FelipeAvilaSilva/Potentiostat_FullyDifferential/README.md

# Potentiostat_FullyDifferential
 Desenvolvimento de um Potenciostato Diferencial para detecção de metais pesados em corpos aquáticos
