FelipeAvilaSilva/Potentiostat_FullyDifferential/Gráficos/placa_ensaio/stock/readme.txt

1 - eletrodo ruim - 1 teste
2 - eletrodo bom 100mv -1v a 1v
3 - eletrodo bom 25mv -1v a 1v
4 - eletrodo bom 25mv 0.2v a 0.8v
