FelipeAvilaSilva/Potentiostat_FullyDifferential/Gráficos/placa_ensaio/fully/resistor155k_fully.png

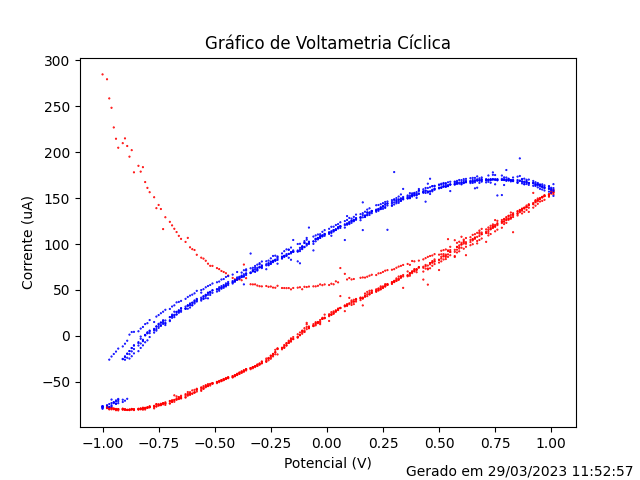
Gráficos/placa_ensaio/fully/resistor155k_fully.png
