FelipeAvilaSilva/Potentiostat_FullyDifferential/Gráficos/placa_ensaio/stock/2_resistor_stock.png

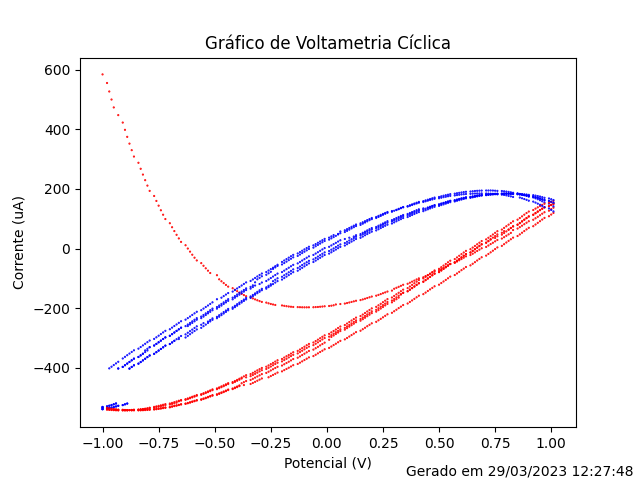
Gráficos/placa_ensaio/stock/2_resistor_stock.png
