FelipeAvilaSilva/Potentiostat_FullyDifferential/Gráficos/placa_ensaio/stock/KOH6M_stock.png

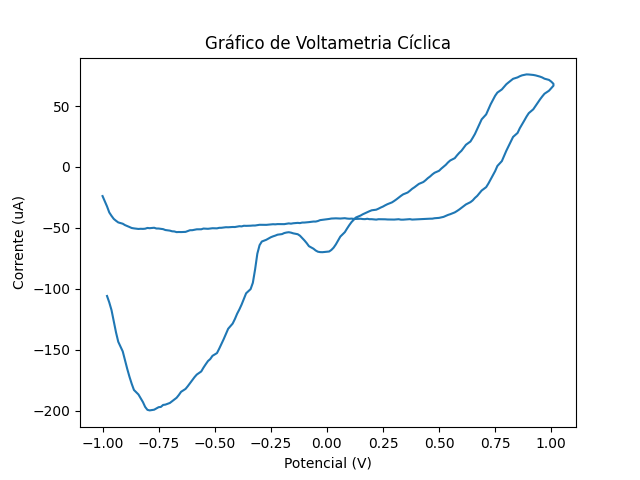
Gráficos/placa_ensaio/stock/KOH6M_stock.png
