FelipeAvilaSilva/Potentiostat_FullyDifferential/Gráficos/placa_ensaio/stock/resistor_stock.png

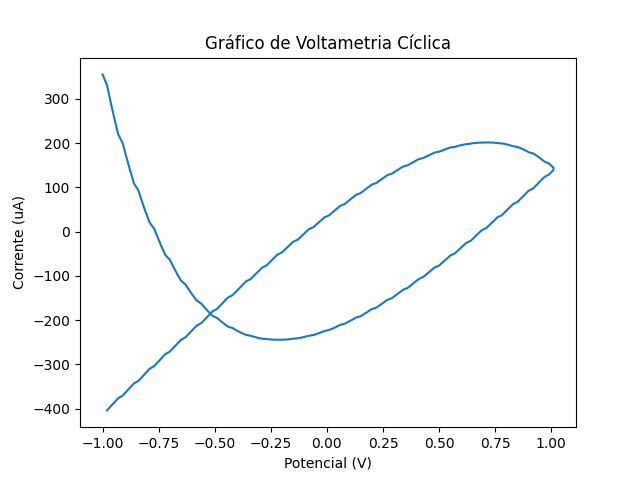
Gráficos/placa_ensaio/stock/resistor_stock.png
