FelipeAvilaSilva/Potentiostat_FullyDifferential/Gráficos/simulação/fully/fully.png

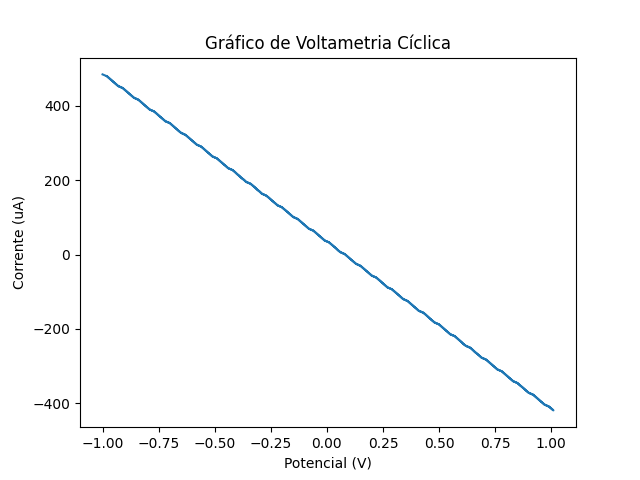
Gráficos/simulação/fully/fully.png
