FelipeAvilaSilva/Potentiostat_FullyDifferential/Gráficos/simulação/fully/fully_sinalinvertido.png

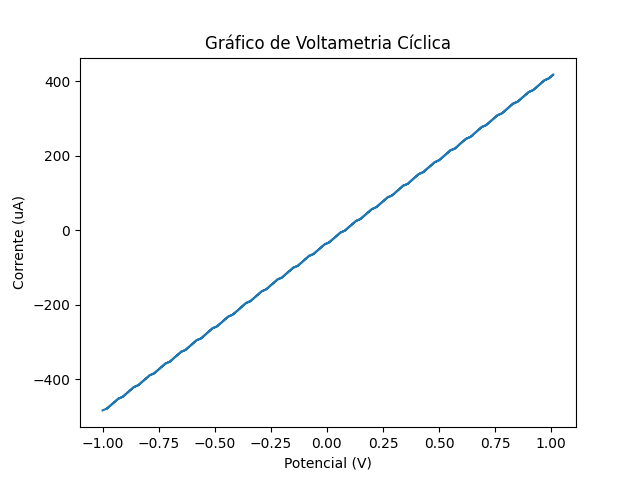
Gráficos/simulação/fully/fully_sinalinvertido.png
