FelipeAvilaSilva/Potentiostat_FullyDifferential/Validação/fully.png

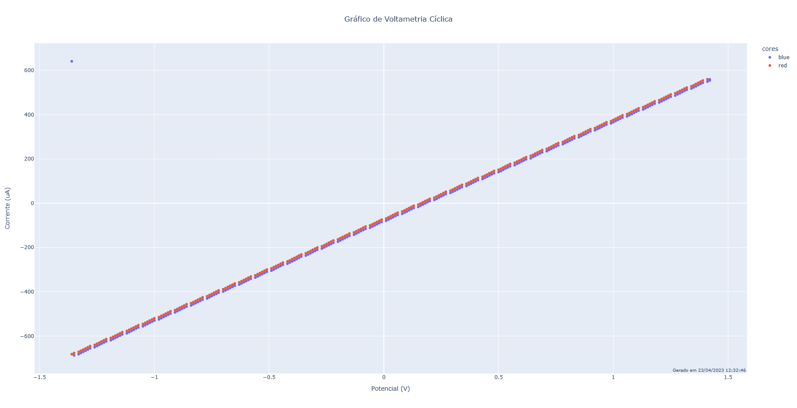
Validação/fully.png
