FelipeAvilaSilva/Potentiostat_FullyDifferential/Validação/PC_Lab/06.12.23-fully/s1_branco_volt_25_1.png

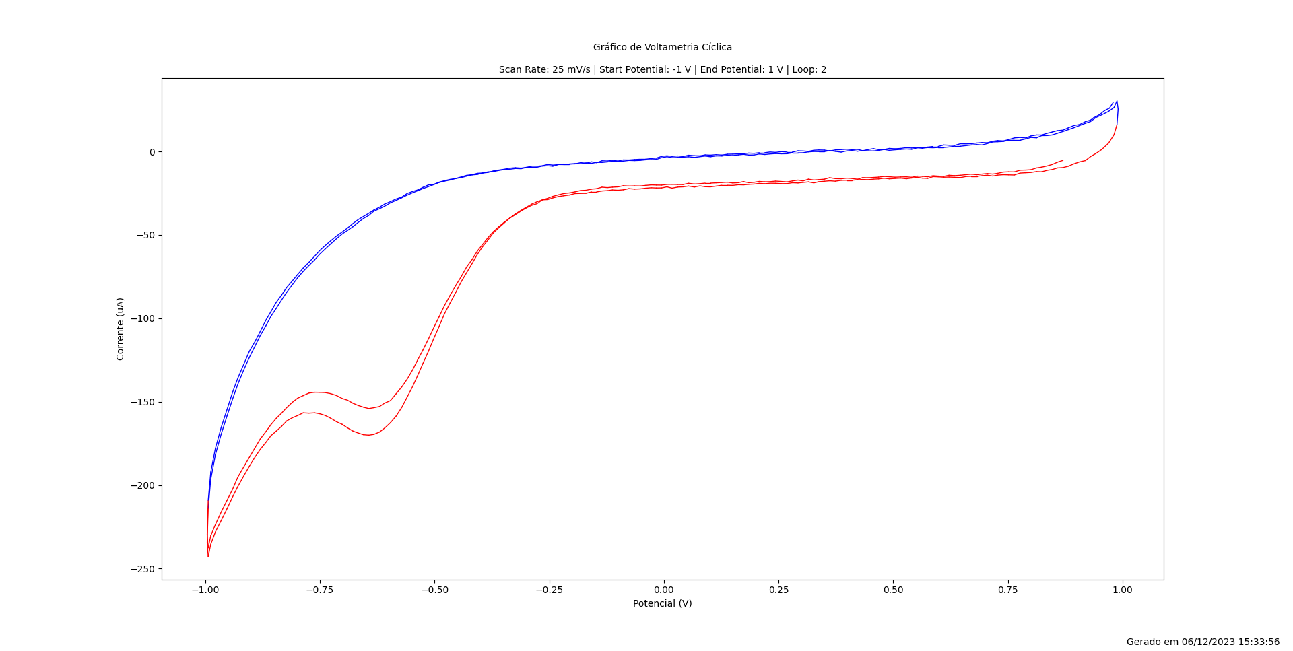
Validação/PC_Lab/06.12.23-fully/s1_branco_volt_25_1.png
