FelipeAvilaSilva/Potentiostat_FullyDifferential/Validação/PC_Lab/06.12.23-fully/s1_branco_volt_50_1.png

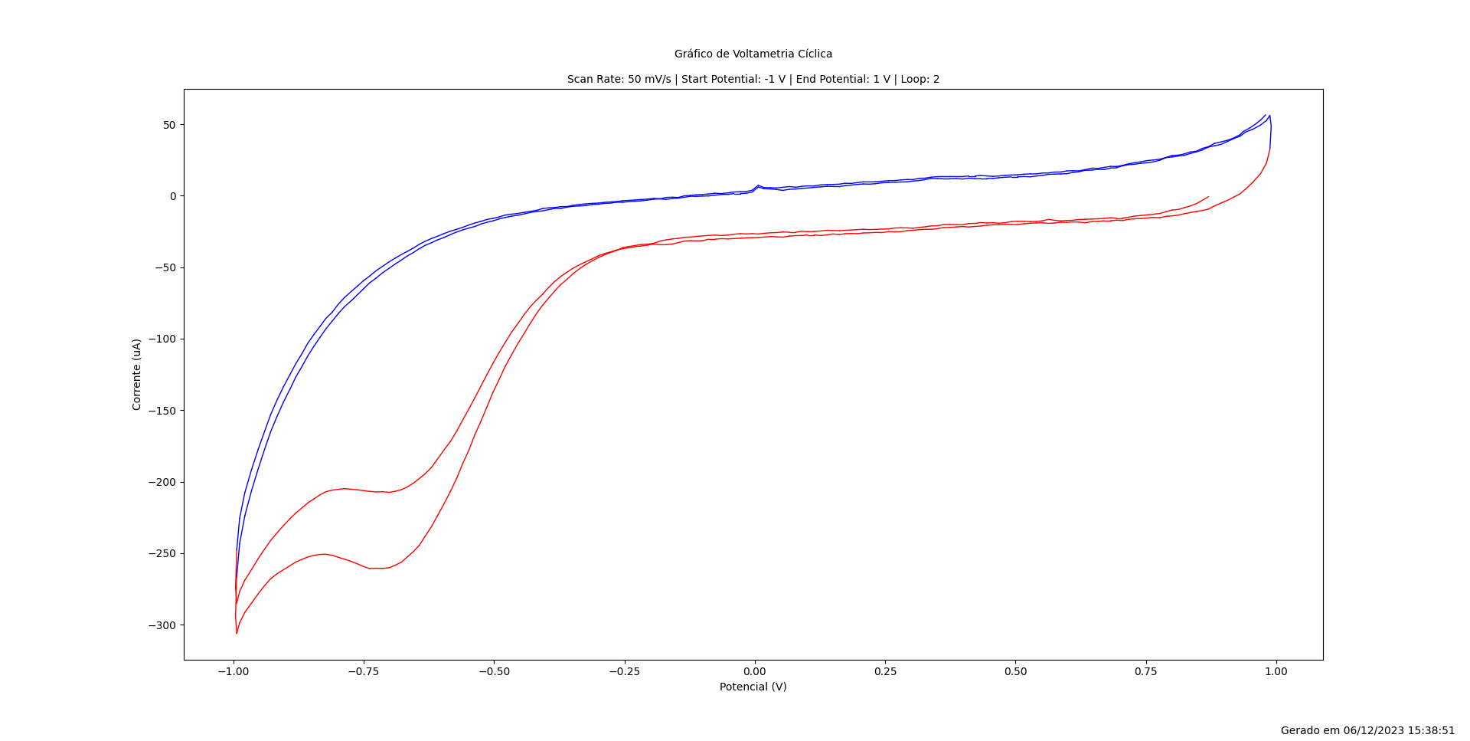
Validação/PC_Lab/06.12.23-fully/s1_branco_volt_50_1.png
