FelipeAvilaSilva/Potentiostat_FullyDifferential/Validação/PC_Lab/06.12.23-fully/s1_cont_volt_50_2.png

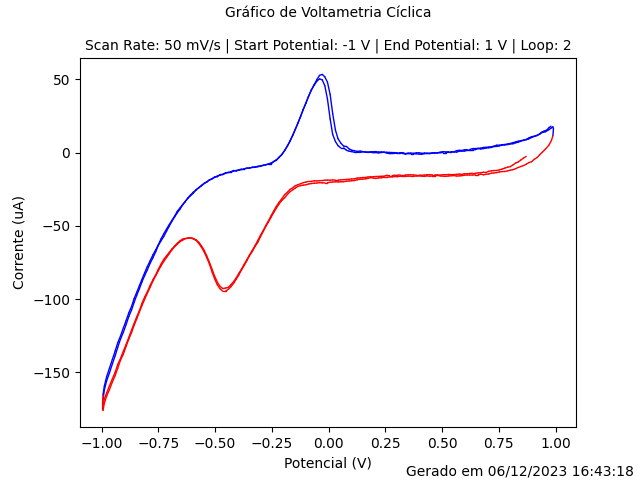
Validação/PC_Lab/06.12.23-fully/s1_cont_volt_50_2.png
