FelipeAvilaSilva/Potentiostat_FullyDifferential/Validação/PC_Lab/06.12.23-fully/s1_cont_volt_150_1.png

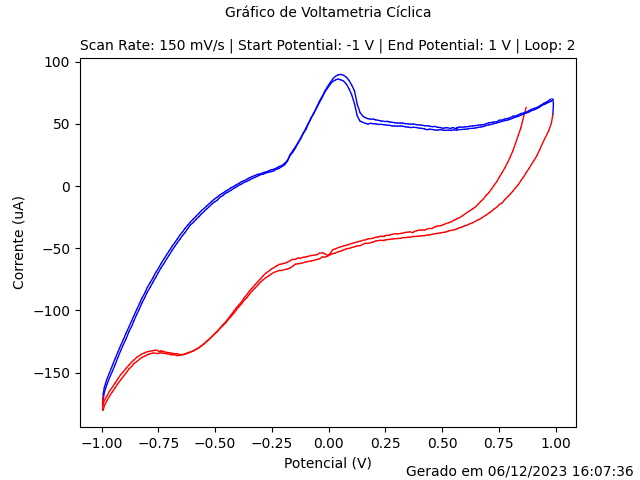
Validação/PC_Lab/06.12.23-fully/s1_cont_volt_150_1.png
