FelipeAvilaSilva/Potentiostat_FullyDifferential/Validação/VfinalFullyPotentiostat2.png

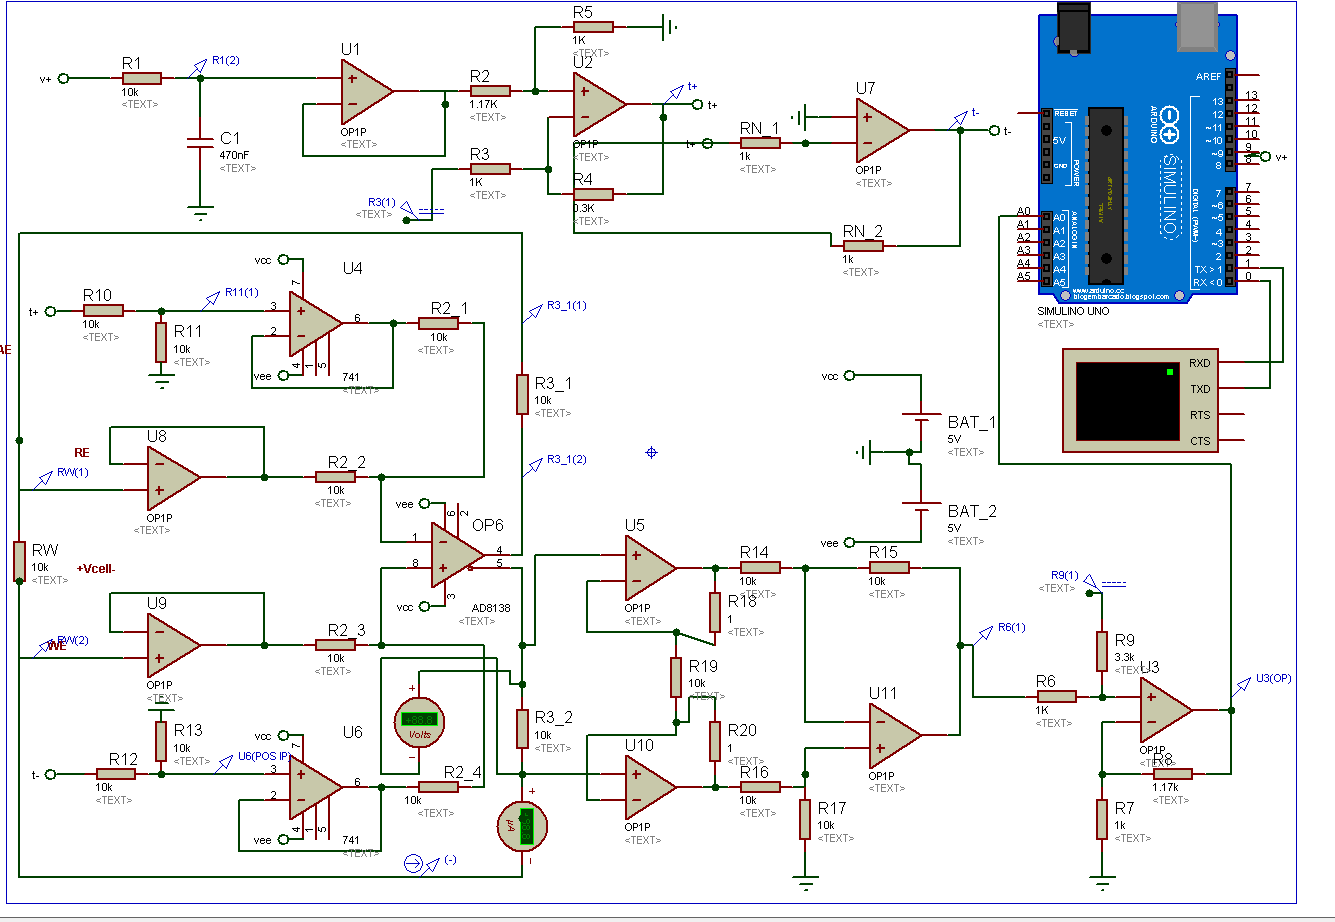
Validação/VfinalFullyPotentiostat2.png
