FelipeAvilaSilva/Potentiostat_FullyDifferential/Validação/vFinalStockPotentiostat2.png

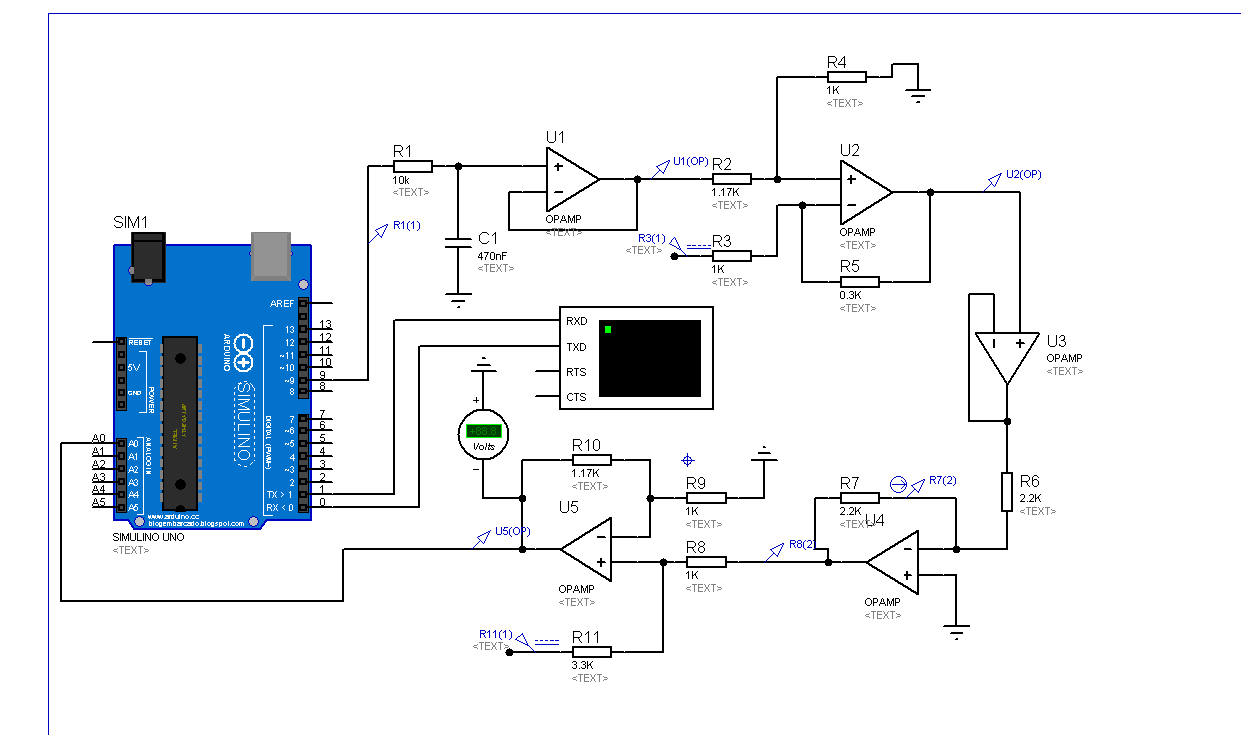
Validação/vFinalStockPotentiostat2.png
