FelipeAvilaSilva/Potentiostat_FullyDifferential/Print/Resistor_Fully_12bits_vTCC.png

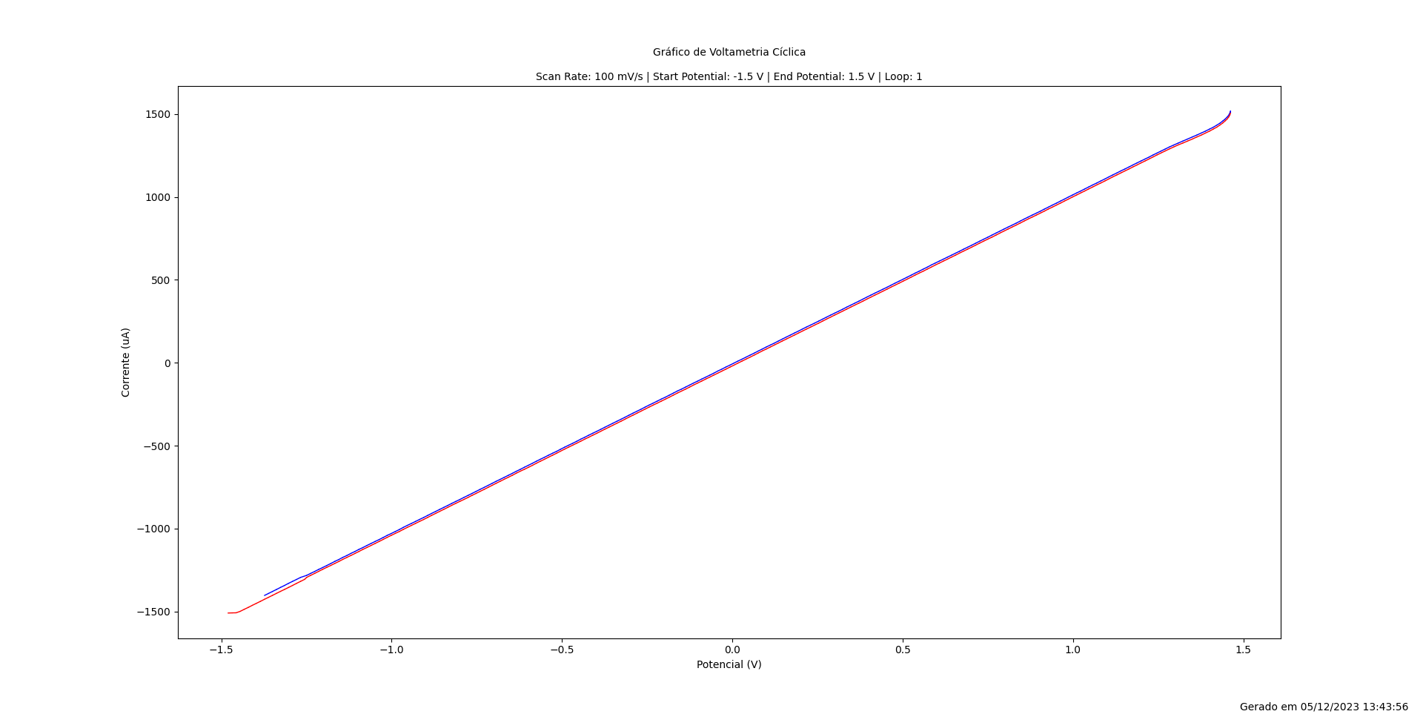
Print/Resistor_Fully_12bits_vTCC.png
