FelipeAvilaSilva/Potentiostat_FullyDifferential/Validação/SE_SIMU.pdf

# 800 Corrente ⁽uA⁾

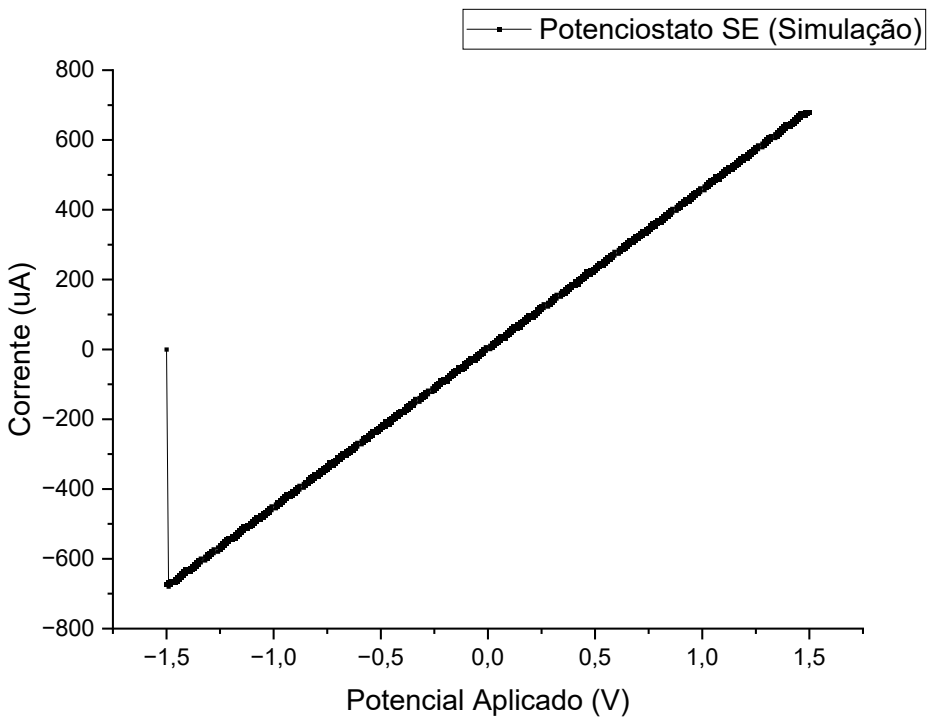
[picture p20: page 1]
Potencial Aplicado (V)

Potenciostato SE (Simulação)
