FelipeAvilaSilva/Potentiostat_FullyDifferential/(list of files, drawings)

Other design files:
Codigo/Proteus/poten_fully.DSN
Codigo/Proteus/poten_fully_v2.DSN
Codigo/Proteus/poten_fully_vfinal.DSN
Codigo/Proteus/poten_fully_vTCC.DSN
Codigo/Proteus/poten_single.DSN
Codigo/Proteus/poten_stock.DSN
Outros_Testes/potenciostato_fully.DSN
Outros_Testes/potenciostato_fully_v2.DSN
Outros_Testes/potenciostato_single_v1.DSN
PCB/fully_differential/fully_differential/freerouting.dsn
