FelipeAvilaSilva/Potentiostat_FullyDifferential/PCB/fully_differential/fully_differential/TCC_FULLY_SMD/TCC_FULLY_SMD.kicad_pcb

## KiCad design PCB/fully_differential/fully_differential/TCC_FULLY_SMD/TCC_FULLY_SMD.kicad_pcb (2024-01-31)

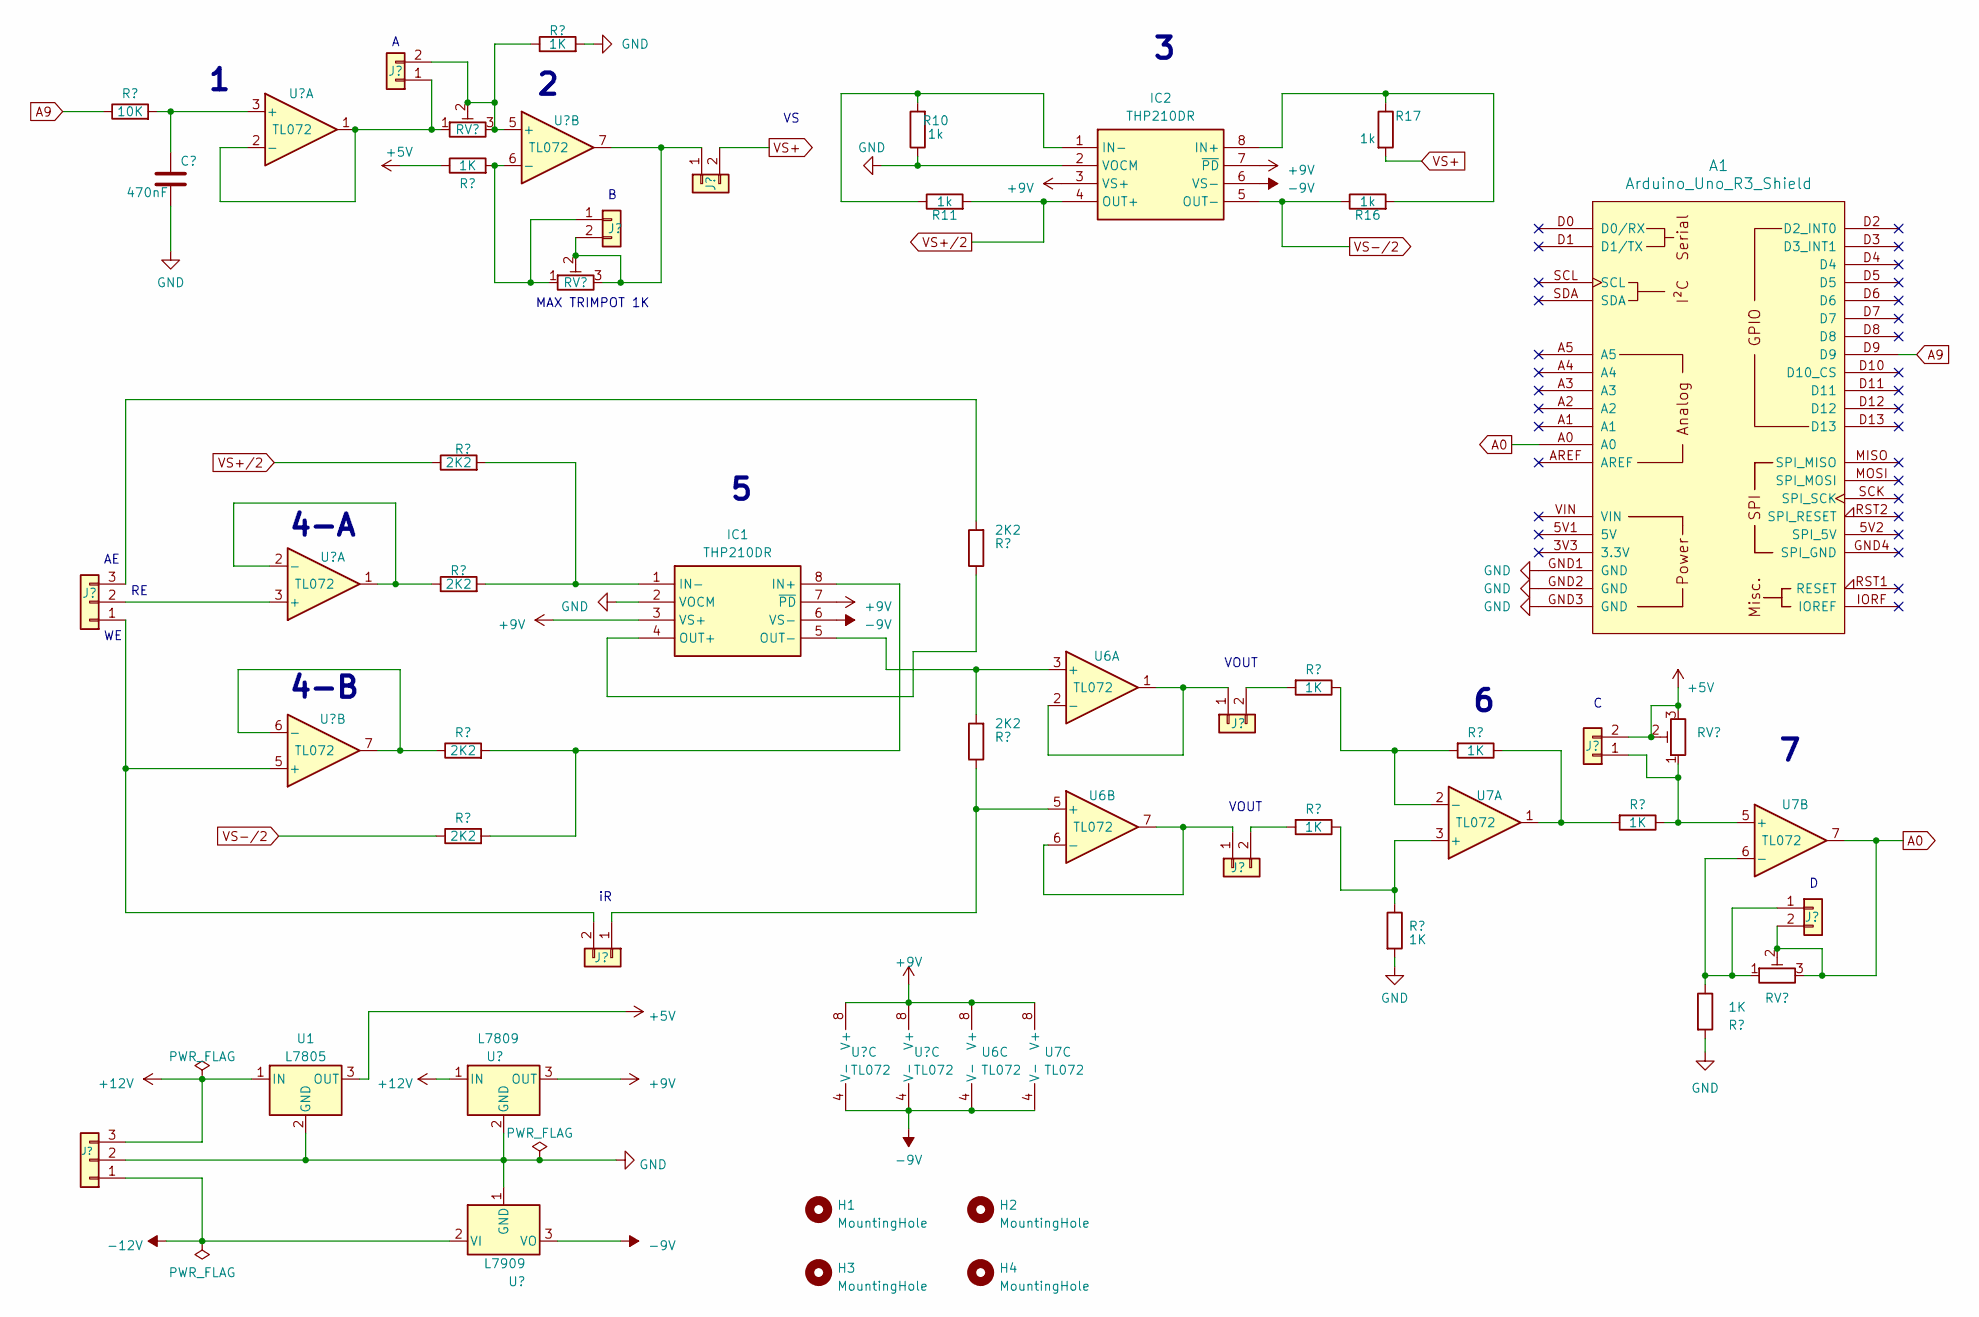
[picture p21: schematic TCC_FULLY_SMD.kicad_sch, Potenciosato Fully Differential]

Parts:
A1: Arduino_Uno_R3_Shield
C2: 470nF; C_Rect_L19.0mm_W6.0mm_P15.00mm_MKS4
H1, H2, H3, H4: MountingHole; MountingHole_3mm_Pad
IC1, IC2: THP210DR; SOIC127P600X175-8N; Mouser Part Number 595-THP210DR
J1: Conn_01x03; PinSocket_1x03_P2.54mm_Vertical
J2: Conn_01x03; Stocko_MKS_1653-6-0-303_1x3_P2.50mm_Vertical
J3, J4, J5, J6, J7, J8, J10, J11: Conn_01x02; PinHeader_1x02_P2.54mm_Vertical
R1: 10K; R_0805_2012Metric_Pad1.20x1.40mm_HandSolder
R2, R3, R4, R5, R8, R9: 2K2; R_0805_2012Metric_Pad1.20x1.40mm_HandSolder
R6, R7, R12, R13, R14, R15, R18, R19: 1K; R_0805_2012Metric_Pad1.20x1.40mm_HandSolder
R10, R11, R16, R17: 1k; R_0805_2012Metric_Pad1.20x1.40mm_HandSolder
RV1, RV2, RV3, RV4: R_Potentiometer_Trim; Potentiometer_Bourns_3296W_Vertical
U1: L7805; TO255P460X1020X2008-3P
U2, U3, U6, U7: TL072; DIP-8_W7.62mm_Socket_LongPads
U4: L7809; TO255P460X1020X2008-3P
U5: L7909; TO255P460X1020X2008-3P

Connections:
+5V: J10.2, R6.1, RV3.2, RV3.3, U1.3 (OUT)
+9V: IC1.3 (VS+), IC1.7 (~PD), IC2.3 (VS+), IC2.7 (~PD), U2.8 (V+), U3.8 (V+), U4.3 (OUT), U6.8 (V+), U7.8 (V+)
+12V: J2.3, U1.1 (IN), U4.1 (IN)
-9V: IC1.6 (VS-), IC2.6 (VS-), U2.4 (V-), U3.4 (V-), U5.3 (VO), U6.4 (V-), U7.4 (V-)
-12V: J2.1, U5.2 (VI)
A0: A1.A0, J11.2, RV4.2, RV4.3, U7.7
A9: A1.D9, R1.1
GND: A1.GND1 (GND), A1.GND2 (GND), A1.GND3 (GND), C2.2, IC1.2 (VOCM), IC2.2 (VOCM), J2.2, R7.2, R10.1, R14.2, R19.2, U1.2 (GND), U4.2 (GND), U5.1 (GND)
unnamed: IC1.8 (IN+), R4.2, R5.2
unnamed: IC1.1 (IN-), R2.2, R3.2
unnamed: IC1.4 (OUT+), R8.1
unnamed: IC1.5 (OUT-), R9.2, U6.3 (+)
unnamed: IC2.8 (IN+), R16.2, R17.1
unnamed: IC2.1 (IN-), R10.2, R11.1
unnamed: J1.1, J4.2, U2.5 (+)
unnamed: J1.2, U2.3 (+)
unnamed: J1.3, R8.2
unnamed: J3.1, RV1.1, U3.1, U3.2 (-)
unnamed: J3.2, R7.1, RV1.2, RV1.3, U3.5 (+)
unnamed: J4.1, R9.1, U6.5 (+)
unnamed: J5.1, R6.2, RV2.1, U3.6 (-)
unnamed: J5.2, J6.1, RV2.2, RV2.3, U3.7
unnamed: J7.1, U6.1, U6.2 (-)
unnamed: J7.2, R12.2
unnamed: J8.1, U6.6 (-), U6.7
unnamed: J8.2, R13.2
unnamed: J10.1, R18.1, RV3.1, U7.5 (+)
unnamed: J11.1, R19.1, RV4.1, U7.6 (-)
unnamed: R15.1, R18.2, U7.1
unnamed: R3.1, U2.1, U2.2 (-)
unnamed: R4.1, U2.6 (-), U2.7
unnamed: C2.1, R1.2, U3.3 (+)
unnamed: R13.1, R14.1, U7.3 (+)
unnamed: R12.1, R15.2, U7.2 (-)
VS+: J6.2, R17.2
VS+/2: IC2.4 (OUT+), R2.1, R11.2
VS-/2: IC2.5 (OUT-), R5.1, R16.1

Notes on the sheet:
VOUT
4-B
4-A
MAX TRIMPOT 1K

Board: 2 copper layers, 48 parts (0 on the bottom side), 37 nets, no tracks yet.
