FelipeAvilaSilva/Potentiostat_FullyDifferential/PCB/stock/stock_v2/stock_v2.kicad_pcb

## KiCad design PCB/stock/stock_v2/stock_v2.kicad_pcb (2023-06-19)

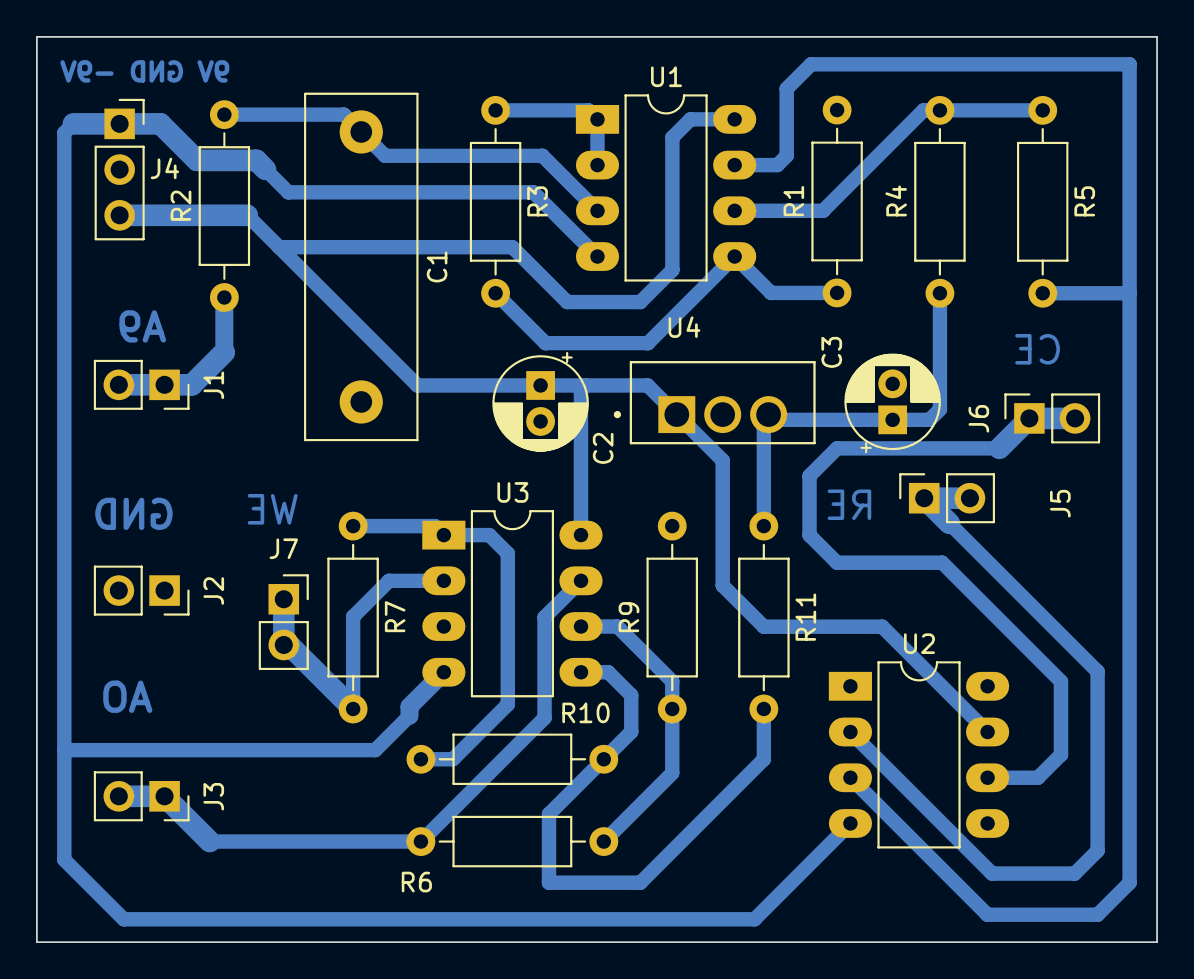
[picture p22: board stock_v2.kicad_pcb from above]

Board: 2 copper layers, 62.2 x 50.3 mm, 24 parts (0 on the bottom side), 17 nets.

Parts:
C1: 470nF; C_Rect_L19.0mm_W6.0mm_P15.00mm_MKS4
C2, C3: 0.3uF; CP_Radial_D5.0mm_P2.00mm
J1, J2, J3, J5, J6, J7: Conn_01x02; PinSocket_1x02_P2.54mm_Vertical
J4: Conn_01x03; PinSocket_1x03_P2.54mm_Vertical
R1, R4, R9, R10: 1K; R_Axial_DIN0207_L6.3mm_D2.5mm_P10.16mm_Horizontal
R2: 10k; R_Axial_DIN0207_L6.3mm_D2.5mm_P10.16mm_Horizontal
R3, R6: 1.17K; R_Axial_DIN0207_L6.3mm_D2.5mm_P10.16mm_Horizontal
R5: 0.3K; R_Axial_DIN0207_L6.3mm_D2.5mm_P10.16mm_Horizontal
R7: 2.2K; R_Axial_DIN0207_L6.3mm_D2.5mm_P10.16mm_Horizontal
R11: 3.3K; R_Axial_DIN0207_L6.3mm_D2.5mm_P10.16mm_Horizontal
U1, U3: LM358; DIP-8_W7.62mm_LongPads
U2: LM741; DIP-8_W7.62mm_LongPads
U4: L7805; TO255P1020X450X2000-3

Connections:
+5V: C3.1, R4.1, R11.1, U4.3 (OUT)
+9V: C2.1, J4.3, U1.8 (V+), U2.7 (V+), U3.8 (V+), U4.1 (IN)
-9V: J4.1, U1.4 (V-), U2.4 (V-), U3.4 (V-)
GND: C1.2, C2.2, C3.2, J2.1, J2.2, J4.2, R1.2, R9.2, U3.3 (+), U4.2 (GND)
unnamed: J1.1, J1.2, R2.1
unnamed: J3.1, J3.2, R6.1, U3.7
unnamed: J5.1, J5.2, U2.2 (-)
unnamed: J6.1, J6.2, U2.6
unnamed: J7.1, J7.2, R7.2, U3.2 (-)
unnamed: R7.1, R10.2, U3.1
unnamed: C1.1, R2.2, U1.3 (+)
unnamed: R3.1, U1.1, U1.2 (-)
unnamed: R1.1, R3.2, U1.5 (+)
unnamed: R4.2, R5.1, U1.6 (-)
unnamed: R5.2, U1.7, U2.3 (+)
unnamed: R10.1, R11.2, U3.5 (+)
unnamed: R6.2, R9.1, U3.6 (-)
