FelipeAvilaSilva/Potentiostat_FullyDifferential/PCB/fully_differential/fully_differential/fully_differential_v8.kicad_pcb

## KiCad design PCB/fully_differential/fully_differential/fully_differential_v8.kicad_pcb (2023-08-18)

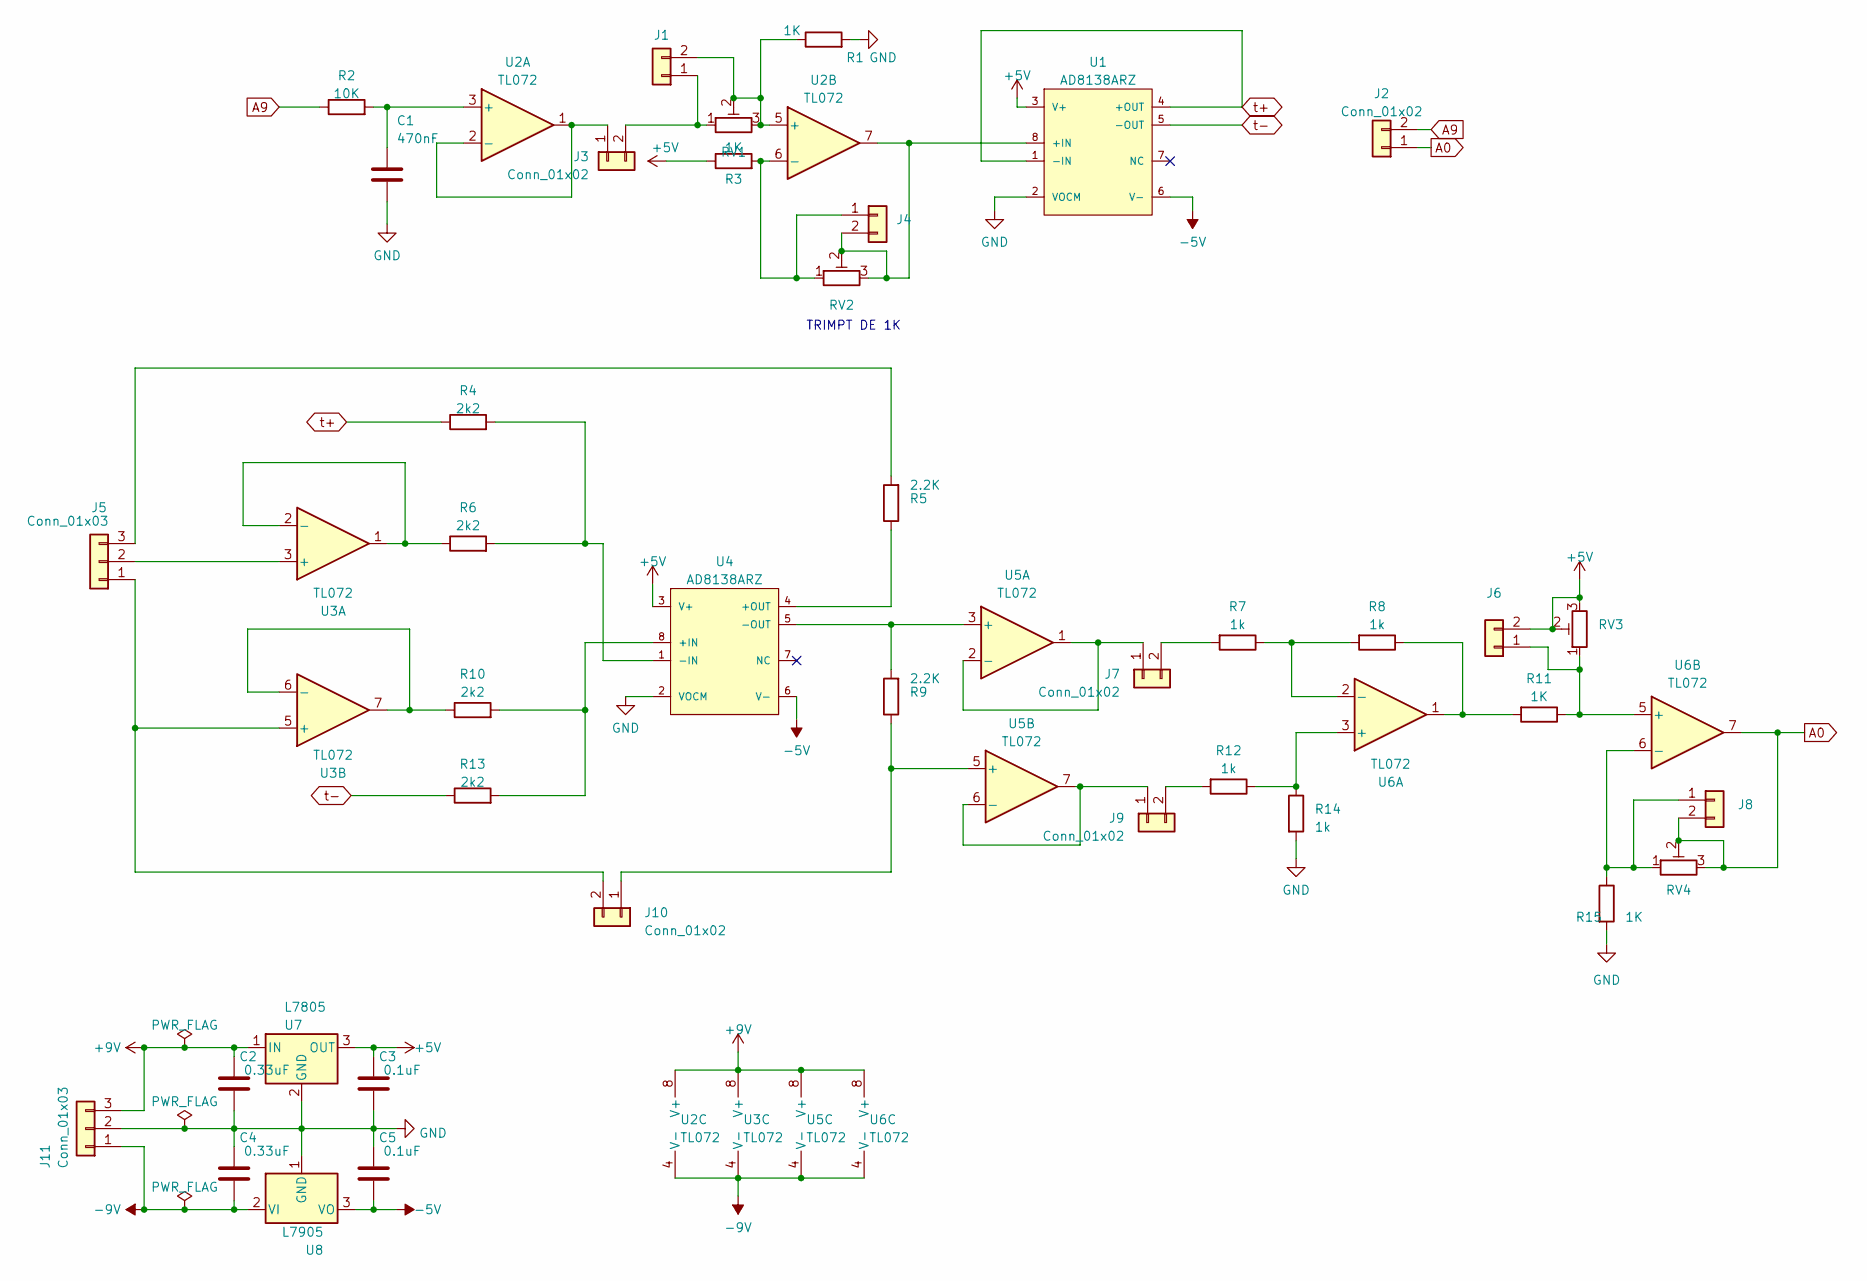
[picture p23: schematic fully_differential_v8.kicad_sch, Fully Differential Potentiostat]

Parts:
C1: 470nF; C_Rect_L19.0mm_W6.0mm_P15.00mm_MKS4
C2, C4: 0.33uF; CP_Radial_D5.0mm_P2.00mm
C3, C5: 0.1uF; CP_Radial_D5.0mm_P2.00mm
J1, J2, J3, J4, J6, J7, J8, J9, J10: Conn_01x02; PinHeader_1x02_P2.54mm_Vertical
J5, J11: Conn_01x03; PinSocket_1x03_P2.54mm_Vertical
R1, R3, R11, R15: 1K; R_Axial_DIN0207_L6.3mm_D2.5mm_P10.16mm_Horizontal
R2: 10K; R_Axial_DIN0207_L6.3mm_D2.5mm_P10.16mm_Horizontal
R4, R6, R10, R13: 2k2; R_Axial_DIN0207_L6.3mm_D2.5mm_P10.16mm_Horizontal
R5, R9: 2.2K; R_Axial_DIN0207_L6.3mm_D2.5mm_P10.16mm_Horizontal
R7, R8, R12, R14: 1k; R_Axial_DIN0207_L6.3mm_D2.5mm_P10.16mm_Horizontal
RV1, RV2, RV3, RV4: R_Potentiometer_Trim; Potentiometer_Bourns_3296W_Vertical
U1, U4: AD8138ARZ; ANALOG_DEVICES_INC_AD8138ARZ_0; mouser part number 584-AD8138ARZ; digikey description IC AMP DIFF LDIST LP 95MA 8SOIC
U2, U3, U5, U6: TL072; DIP-8_W7.62mm_Socket_LongPads
U7: L7805; TO255P1020X450X2000-3
U8: L7905; TO255P1020X450X2000-3

Connections:
+5V: C3.1, J6.2, R3.1, RV3.2, RV3.3, U1.3 (V+), U4.3 (V+), U7.3 (OUT)
+9V: C2.1, J11.3, U2.8 (V+), U3.8 (V+), U5.8 (V+), U6.8 (V+), U7.1 (IN)
-5V: C5.2, U1.6 (V-), U4.6 (V-), U8.3 (VO)
-9V: C4.2, J11.1, U2.4 (V-), U3.4 (V-), U5.4 (V-), U6.4 (V-), U8.2 (VI)
A0: J2.1, J8.2, RV4.2, RV4.3, U6.7
A9: J2.2, R2.1
GND: C1.2, C2.2, C3.2, C4.1, C5.1, J11.2, R1.2, R14.2, R15.2, U1.2 (VOCM), U4.2 (VOCM), U7.2 (GND), U8.1 (GND)
unnamed: J1.1, J3.2, RV1.1
unnamed: J1.2, R1.1, RV1.2, RV1.3, U2.5 (+)
unnamed: J3.1, U2.1, U2.2 (-)
unnamed: J4.1, R3.2, RV2.1, U2.6 (-)
unnamed: J4.2, RV2.2, RV2.3, U1.8 (+IN), U2.7
unnamed: J5.2, U3.3 (+)
unnamed: J5.3, R5.2
unnamed: J6.1, R11.1, RV3.1, U6.5 (+)
unnamed: J7.1, U5.1, U5.2 (-)
unnamed: J7.2, R7.2
unnamed: J8.1, R15.1, RV4.1, U6.6 (-)
unnamed: J9.1, U5.6 (-), U5.7
unnamed: J9.2, R12.2
unnamed: J10.1, R9.1, U5.5 (+)
unnamed: J5.1, J10.2, U3.5 (+)
unnamed: R8.1, R11.2, U6.1
unnamed: C1.1, R2.2, U2.3 (+)
unnamed: R6.1, U3.1, U3.2 (-)
unnamed: R10.1, U3.6 (-), U3.7
unnamed: R10.2, R13.2, U4.8 (+IN)
unnamed: R5.1, U4.4 (+OUT)
unnamed: R4.2, R6.2, U4.1 (-IN)
unnamed: R9.2, U4.5 (-OUT), U5.3 (+)
unnamed: R12.1, R14.1, U6.3 (+)
unnamed: R7.1, R8.2, U6.2 (-)
t+: R4.1, U1.1 (-IN), U1.4 (+OUT)
t-: R13.1, U1.5 (-OUT)

Notes on the sheet:
TRIMPT DE 1K

Board: 2 copper layers, 43 parts (2 on the bottom side), 34 nets, no tracks yet.
