FelipeAvilaSilva/Potentiostat_FullyDifferential/PCB/fully_differential/fully_differential/fully_differential_v2.kicad_pcb

## KiCad design PCB/fully_differential/fully_differential/fully_differential_v2.kicad_pcb (2023-06-19, an earlier design)

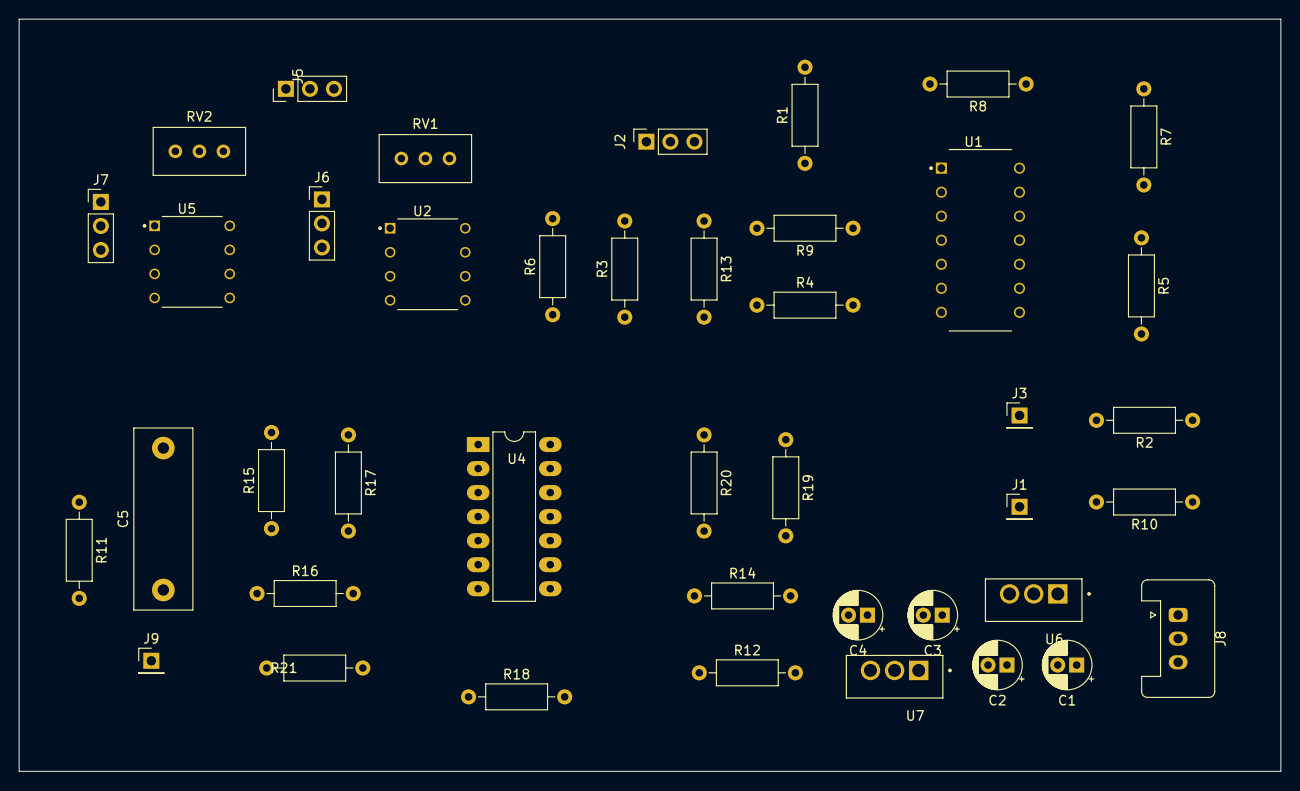
[picture p25: board fully_differential_v2.kicad_pcb from above]

Board: 2 copper layers, 133.3 x 79.5 mm, 43 parts (1 on the bottom side), 37 nets, no tracks yet.

Parts:
C1, C2, C3, C4: 0.3uF; CP_Radial_D5.0mm_P2.00mm
C5: 470nF; C_Rect_L19.0mm_W6.0mm_P15.00mm_MKS4
J1: PIN_A0; PinHeader_1x01_P2.54mm_Vertical
J2: Conn_01x03; PinSocket_1x03_P2.54mm_Vertical
J3: Conn_01x01; PinHeader_1x01_P2.54mm_Vertical
J5, J6, J7: Conn_01x03; PinHeader_1x03_P2.54mm_Vertical
J8: Conn_01x03; Stocko_MKS_1653-6-0-303_1x3_P2.50mm_Vertical
J9: PIN_09; PinHeader_1x01_P2.54mm_Vertical
R1, R2, R5, R8, R9, R10, R15, R18, R19, R20: 1K; R_Axial_DIN0207_L6.3mm_D2.5mm_P10.16mm_Horizontal
R3, R11, R12, R14, R16: 10K; R_Axial_DIN0207_L6.3mm_D2.5mm_P10.16mm_Horizontal
R4: 3.3K; R_Axial_DIN0207_L6.3mm_D2.5mm_P10.16mm_Horizontal
R6, R13: 2.2K; R_Axial_DIN0207_L6.3mm_D2.5mm_P10.16mm_Horizontal
R7: 1.17K; R_Axial_DIN0207_L6.3mm_D2.5mm_P10.16mm_Horizontal
R17: 2.83K; R_Axial_DIN0207_L6.3mm_D2.5mm_P10.16mm_Horizontal
R21: 150; R_Axial_DIN0207_L6.3mm_D2.5mm_P10.16mm_Horizontal
RV1, RV2: R_Potentiometer_Trim; Potentiometer_Bourns_3296W_Vertical
U1: LM324; DIP825W47P254L1917H533Q14
U2, U5: LM741; DIP794W45P254L959H508Q8
U3: AD8138ARZ; ANALOG_DEVICES_INC_AD8138ARZ_0
U4: LM324; DIP-14_W7.62mm_LongPads
U6: L7805; TO255P1020X450X2000-3
U7: L7905; TO255P1020X450X2000-3

Connections:
+5V: C2.1, R4.1, R19.1, U3.3 (V+), U6.3 (OUT)
+9V: C1.1, J8.3, U2.7 (V+), U4.4 (V+), U5.7 (V+), U6.1 (IN)
-5V: C4.2, U3.6 (V-), U7.3 (VO)
-9V: C3.2, J5.1, J8.1, U2.4 (V-), U4.11 (V-), U5.4 (V-), U7.2 (VI)
GND: C1.2, C2.2, C3.1, C4.1, C5.2, J3.1, J8.2, R9.2, R10.2, R15.2, U4.10 (+), U6.2 (GND), U7.1 (GND)
unnamed: J1.1, R7.1, U1.14
unnamed: J2.1, R13.1, U5.3 (+)
unnamed: J2.2, U2.3 (+)
unnamed: J2.3, R6.2, U1.3 (+)
unnamed: J5.2, RV1.2, RV2.2
unnamed: J6.2, RV1.3
unnamed: J7.2, RV2.3
unnamed: J9.1, R16.1
unnamed: R2.1, R5.2, U1.8
unnamed: R1.2, U1.1, U1.2 (-)
unnamed: R6.1, U1.5 (+), U3.4 (+OUT)
unnamed: R8.2, U1.6 (-), U1.7
unnamed: R8.1, R10.1, U1.10 (+)
unnamed: R1.1, R2.2, U1.9 (-)
unnamed: R4.2, R5.1, U1.12 (+)
unnamed: R7.2, R9.1, U1.13 (-)
unnamed: R11.1, U2.2 (-), U2.6
unnamed: R12.2, R14.2, U3.8 (+IN)
unnamed: R3.2, R11.2, U3.1 (-IN)
unnamed: R13.2, U3.5 (-OUT)
unnamed: C5.1, R16.2, U4.3 (+)
unnamed: R17.1, U4.1, U4.2 (-)
unnamed: R15.1, R17.2, U4.5 (+)
unnamed: R19.2, R21.1, U4.6 (-)
unnamed: R18.2, R20.1, U4.9 (-)
unnamed: R12.1, U5.2 (-), U5.6
op2_1: J6.1, U2.1 (NULL)
op2_2: RV1.1, U2.5 (NULL)
op3_1: J7.1, U5.1 (NULL)
op3_2: RV2.1, U5.5 (NULL)
t+: R3.1, R18.1, R21.2, U4.7
t-: R14.1, R20.2, U4.8
