FelipeAvilaSilva/Potentiostat_FullyDifferential/PCB/fully_differential/fully_differential/fully_differential.kicad_pcb

## KiCad design PCB/fully_differential/fully_differential/fully_differential.kicad_pcb (2023-05-26, an earlier design)

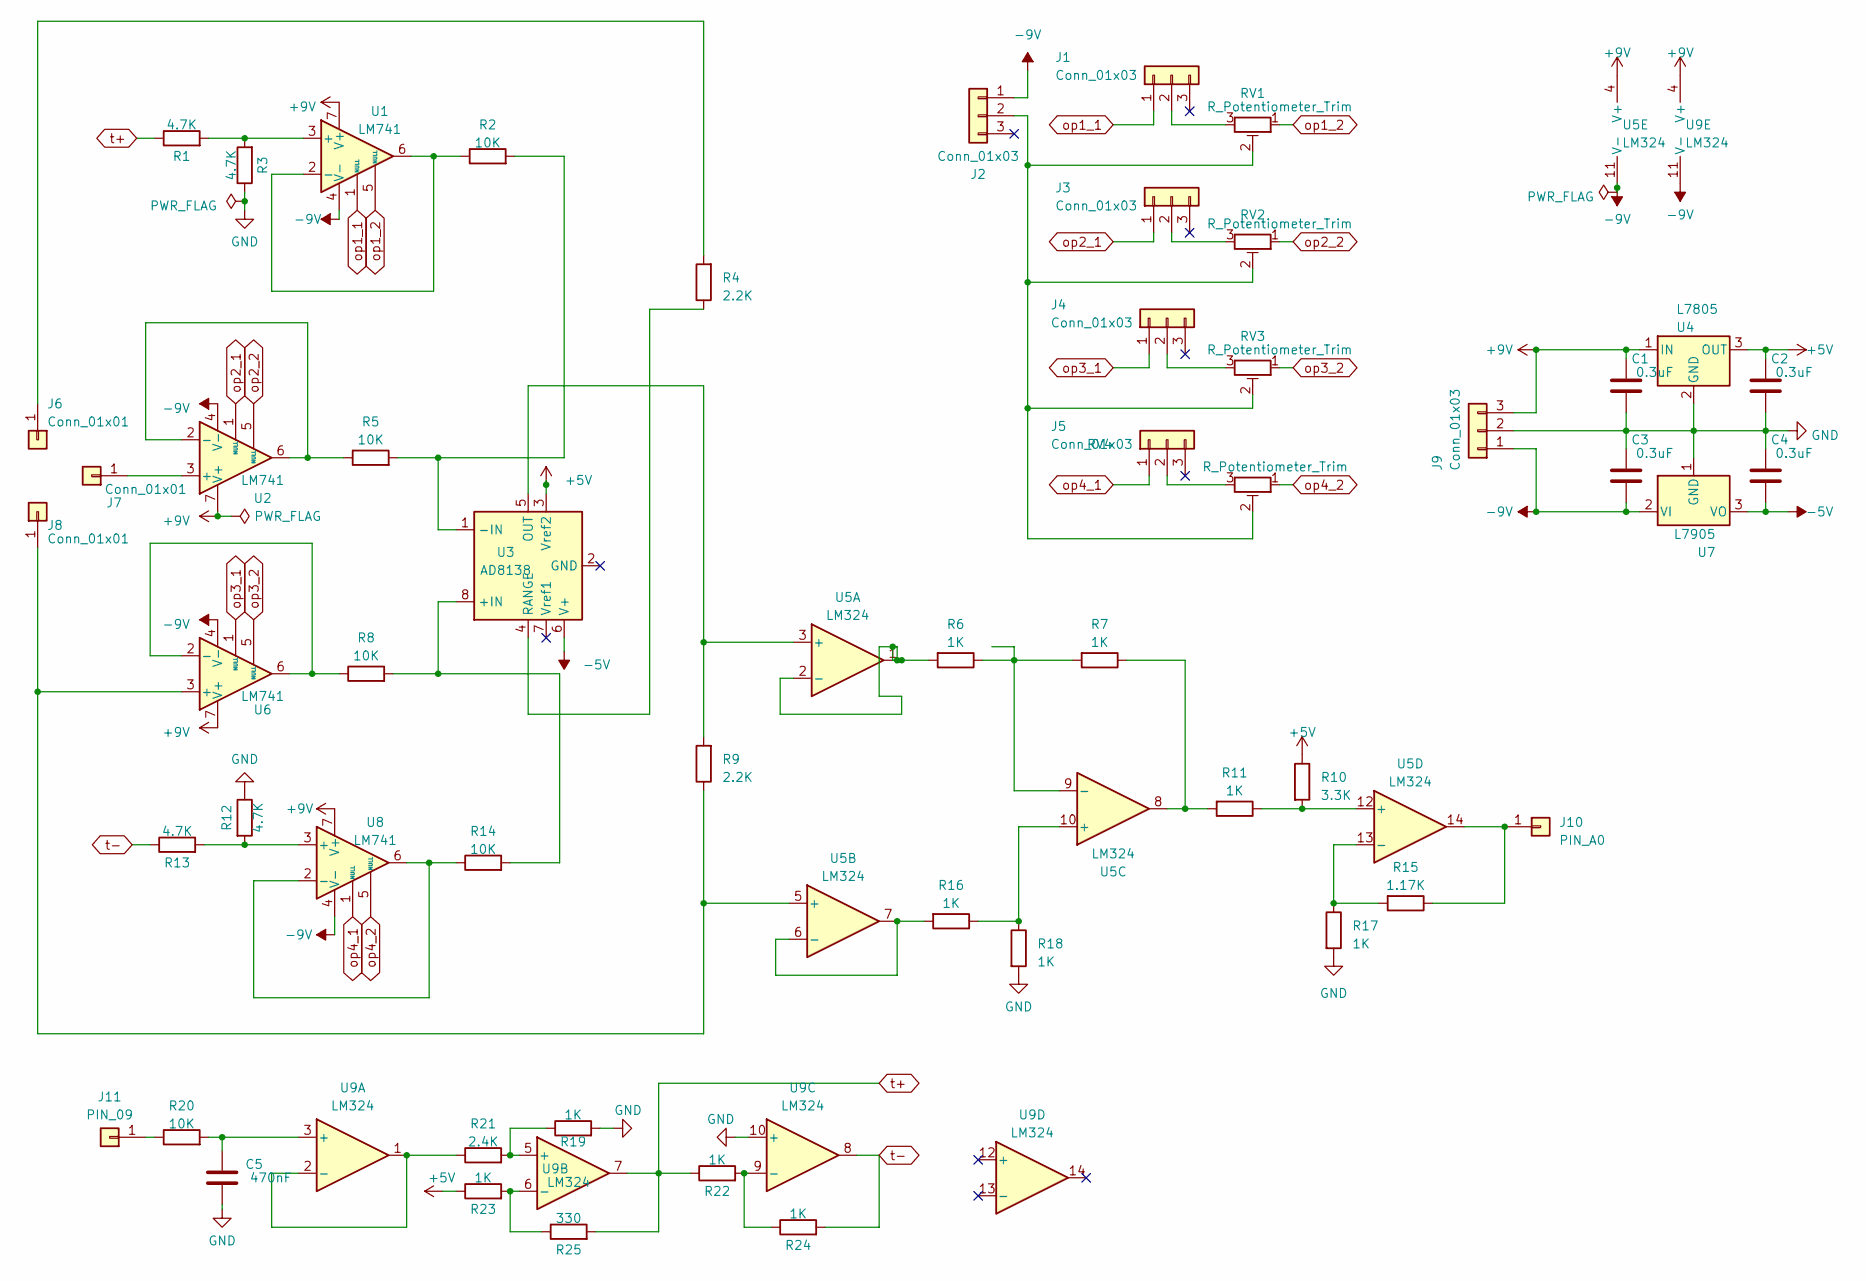
[picture p26: schematic fully_differential.kicad_sch, Fully Differential Potentiostat]

Parts:
C1, C2, C3, C4: 0.3uF; CP_Radial_D5.0mm_P2.00mm
C5: 470nF; C_Rect_L19.0mm_W6.0mm_P15.00mm_MKS4
J1, J2, J3, J4, J5: Conn_01x03; PinHeader_1x03_P2.54mm_Vertical
J6, J7, J8: Conn_01x01; PinHeader_1x01_P2.54mm_Vertical
J9: Conn_01x03; Stocko_MKS_1653-6-0-303_1x3_P2.50mm_Vertical
J10: PIN_A0; PinHeader_1x01_P2.54mm_Vertical
J11: PIN_09; PinHeader_1x01_P2.54mm_Vertical
R1, R3, R12, R13: 4.7K; R_Axial_DIN0207_L6.3mm_D2.5mm_P10.16mm_Horizontal
R2, R5, R8, R14, R20: 10K; R_Axial_DIN0207_L6.3mm_D2.5mm_P10.16mm_Horizontal
R4, R9: 2.2K; R_Axial_DIN0207_L6.3mm_D2.5mm_P10.16mm_Horizontal
R6, R7, R11, R16, R17, R18, R19, R22, R23, R24: 1K; R_Axial_DIN0207_L6.3mm_D2.5mm_P10.16mm_Horizontal
R10: 3.3K; R_Axial_DIN0207_L6.3mm_D2.5mm_P10.16mm_Horizontal
R15: 1.17K; R_Axial_DIN0207_L6.3mm_D2.5mm_P10.16mm_Horizontal
R21: 2.4K; R_Axial_DIN0207_L6.3mm_D2.5mm_P10.16mm_Horizontal
R25: 330; R_Axial_DIN0207_L6.3mm_D2.5mm_P10.16mm_Horizontal
RV1, RV2, RV3, RV4: R_Potentiometer_Trim; Potentiometer_Bourns_3296W_Vertical
U1, U2, U6, U8: LM741; DIP794W45P254L959H508Q8
U3: AD8138; SOIC-8_3.9x4.9mm_P1.27mm
U4: L7805; TO255P1020X450X2000-3
U5, U9: LM324; DIP825W47P254L1917H533Q14
U7: L7905; TO255P1020X450X2000-3

Connections:
+5V: C2.1, R10.1, R23.1, U3.3 (Vref2), U4.3 (OUT)
+9V: C1.1, J9.3, U1.7 (V+), U2.7 (V+), U4.1 (IN), U5.4 (V+), U6.7 (V+), U8.7 (V+), U9.4 (V+)
-5V: C4.2, U3.6 (V+), U7.3 (VO)
-9V: C3.2, J2.1, J9.1, U1.4 (V-), U2.4 (V-), U5.11 (V-), U6.4 (V-), U7.2 (VI), U8.4 (V-), U9.11 (V-)
GND: C1.2, C2.2, C3.1, C4.1, C5.2, J9.2, R3.1, R12.1, R17.2, R18.2, R19.2, U4.2 (GND), U7.1 (GND), U9.10 (+)
unnamed: J1.2, RV1.3
unnamed: J2.2, RV1.2, RV2.2, RV3.2, RV4.2
unnamed: J3.2, RV2.3
unnamed: J4.2, RV3.3
unnamed: J5.2, RV4.3
unnamed: J6.1, R4.2
unnamed: J7.1, U2.3 (+)
unnamed: J8.1, R9.1, U5.5 (+), U6.3 (+)
unnamed: J10.1, R15.1, U5.14
unnamed: J11.1, R20.1
unnamed: R7.1, R11.2, U5.8
unnamed: R1.2, R3.2, U1.3 (+)
unnamed: R2.1, U1.2 (-), U1.6
unnamed: R5.1, U2.2 (-), U2.6
unnamed: R8.2, R14.2, U3.8 (+IN)
unnamed: R2.2, R5.2, U3.1 (-IN)
unnamed: R9.2, U3.5 (OUT), U5.3 (+)
unnamed: R4.1, U3.4 (RANGE)
unnamed: R6.2, U5.1, U5.2 (-)
unnamed: R16.2, U5.6 (-), U5.7
unnamed: R16.1, R18.1, U5.10 (+)
unnamed: R6.1, R7.2, U5.9 (-)
unnamed: R10.2, R11.1, U5.12 (+)
unnamed: R15.2, R17.1, U5.13 (-)
unnamed: R8.1, U6.2 (-), U6.6
unnamed: R12.2, R13.2, U8.3 (+)
unnamed: R14.1, U8.2 (-), U8.6
unnamed: C5.1, R20.2, U9.3 (+)
unnamed: R21.1, U9.1, U9.2 (-)
unnamed: R19.1, R21.2, U9.5 (+)
unnamed: R23.2, R25.1, U9.6 (-)
unnamed: R22.2, R24.1, U9.9 (-)
op1_1: J1.1, U1.1 (NULL)
op1_2: RV1.1, U1.5 (NULL)
op2_1: J3.1, U2.1 (NULL)
op2_2: RV2.1, U2.5 (NULL)
op3_1: J4.1, U6.1 (NULL)
op3_2: RV3.1, U6.5 (NULL)
op4_1: J5.1, U8.1 (NULL)
op4_2: RV4.1, U8.5 (NULL)
t+: R1.1, R22.1, R25.2, U9.7
t-: R13.1, R24.2, U9.8

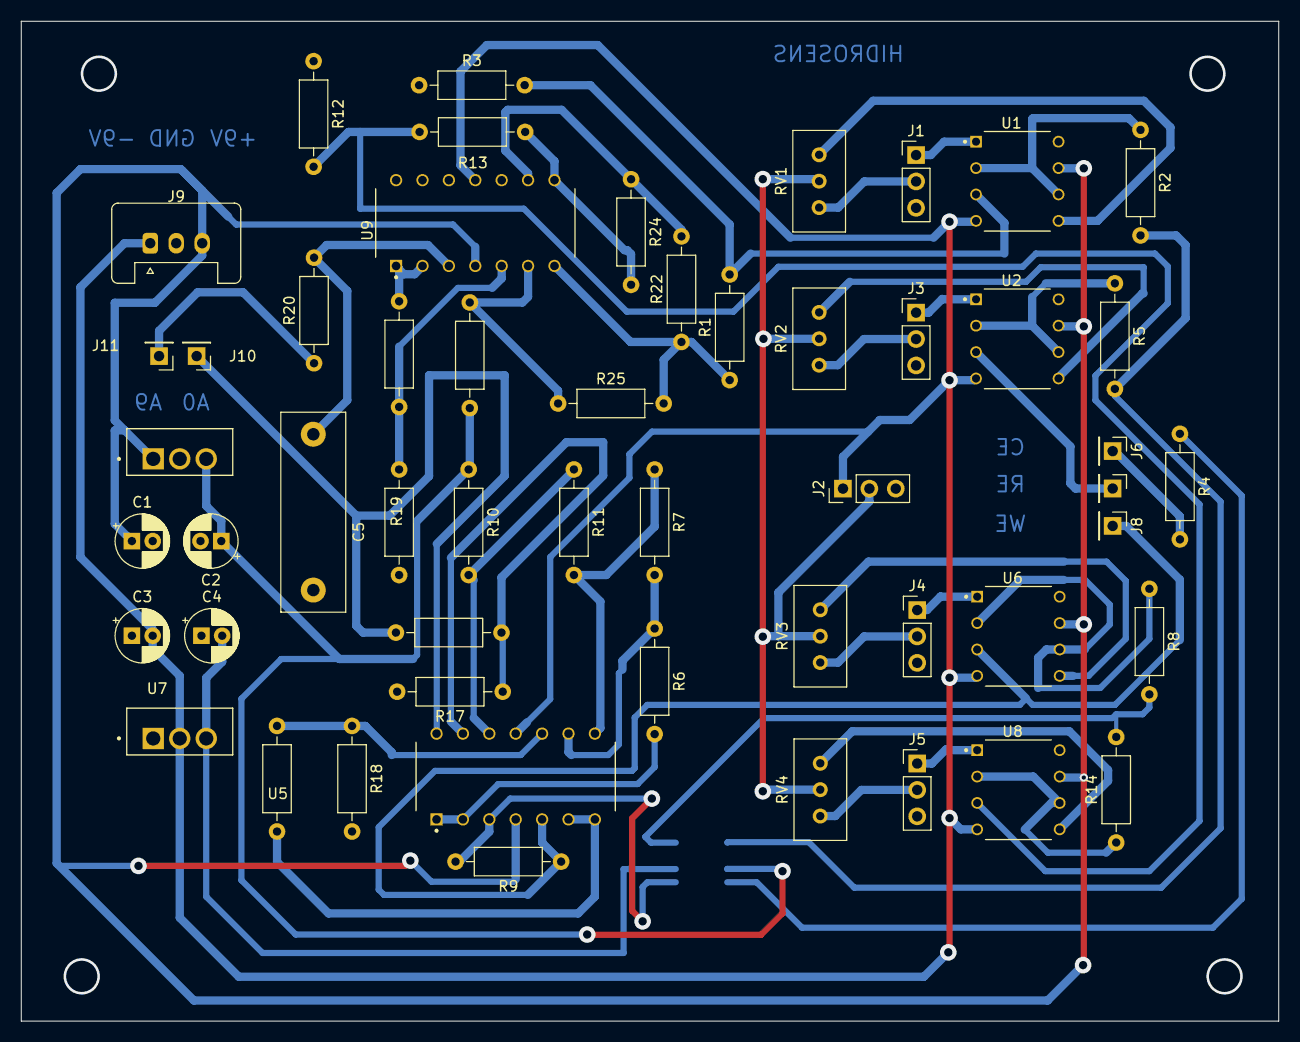
[picture p27: board fully_differential.kicad_pcb from above]

Board: 2 copper layers, 121.0 x 96.2 mm, 54 parts (1 on the bottom side), 47 nets.
