FelipeAvilaSilva/Potentiostat_FullyDifferential/PCB/stock/stock.kicad_pcb

## KiCad design PCB/stock/stock.kicad_pcb (2023-04-25)

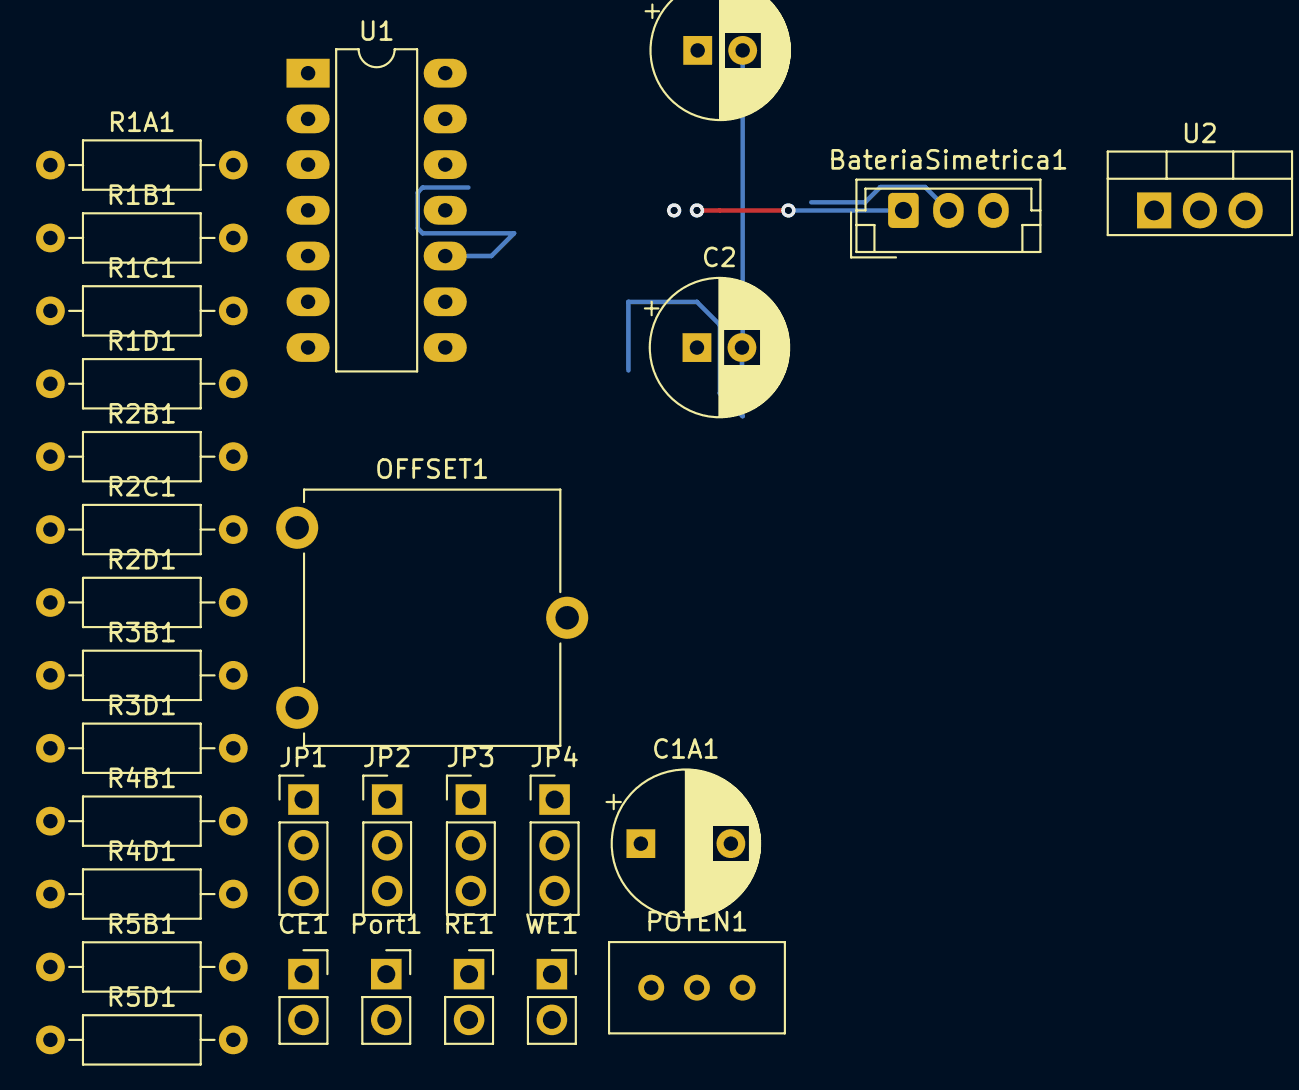
[picture p28: board stock.kicad_pcb from above]

Board: 2 copper layers, 29 parts (0 on the bottom side), 25 nets.

Parts:
BateriaSimetrica1: Screw_Terminal_01x03; JST_EH_B3B-EH-A_1x03_P2.50mm_Vertical
C1, C2: 3.3uF; CP_Radial_D7.5mm_P2.50mm
C1A1: C_Polarized; CP_Radial_D8.0mm_P5.00mm
CE1: Screw_Terminal_01x01; PinSocket_1x02_P2.54mm_Vertical
JP1, JP2, JP3, JP4: Jumper_3_Bridged12; PinHeader_1x03_P2.54mm_Vertical
OFFSET1: R_Potentiometer_Trim; Potentiometer_ACP_CA14V-15_Vertical
POTEN1: LM741; Potentiometer_Bourns_3296W_Vertical
Port1: PortA0; PinSocket_1x02_P2.54mm_Vertical
R1A1: 10k; R_Axial_DIN0207_L6.3mm_D2.5mm_P10.16mm_Horizontal
R1B1, R1D1, R2D1, R4D1: 1k; R_Axial_DIN0207_L6.3mm_D2.5mm_P10.16mm_Horizontal
R1C1: 2.2K; R_Axial_DIN0207_L6.3mm_D2.5mm_P10.16mm_Horizontal
R2B1, R3D1: 160; R_Axial_DIN0207_L6.3mm_D2.5mm_P10.16mm_Horizontal
R2C1: 2.2k; R_Axial_DIN0207_L6.3mm_D2.5mm_P10.16mm_Horizontal
R3B1, R4B1: 1K; R_Axial_DIN0207_L6.3mm_D2.5mm_P10.16mm_Horizontal
R5B1: 300; R_Axial_DIN0207_L6.3mm_D2.5mm_P10.16mm_Horizontal
R5D1: 3.3k; R_Axial_DIN0207_L6.3mm_D2.5mm_P10.16mm_Horizontal
RE1: Screw_Terminal_01x01; PinSocket_1x02_P2.54mm_Vertical
U1: LM324; DIP-14_W7.62mm_LongPads
U2: L7805; TO-220-3_Vertical
WE1: Screw_Terminal_01x01; PinSocket_1x02_P2.54mm_Vertical

Connections:
+5V: C2.1, R4B1.1, R5D1.2, U2.3 (OUT)
+12V: BateriaSimetrica1.1, C1.1, U1.4 (V+), U2.1 (IN)
-12V: BateriaSimetrica1.3, OFFSET1.2, U1.11 (V-)
GND: BateriaSimetrica1.2, C1.2, C1A1.2, C2.2, R2D1.1, R3B1.1, U1.10 (+), U2.2 (GND)
unnamed: CE1.1, JP3.3 (B)
unnamed: JP1.1 (A), JP3.1 (A), JP4.2 (C)
unnamed: JP1.3 (B), WE1.1
unnamed: JP1.2 (C), JP2.3 (B), POTEN1.2 (-)
unnamed: JP2.1 (A), R5B1.1, U1.7
unnamed: JP2.2 (C), POTEN1.3 (+)
unnamed: JP4.1 (A), R1C1.1
unnamed: JP4.3 (B), RE1.1
unnamed: OFFSET1.1, POTEN1.1 (NULL)
unnamed: Port1.1, R1A1.1
unnamed: Port1.2, R4D1.2, U1.14
unnamed: R1B1.2, R2B1.1
unnamed: R1D1.1, R2C1.2, U1.8
unnamed: R3D1.1, R4D1.1
unnamed: C1A1.1, R1A1.2, U1.3 (+)
unnamed: R1B1.1, U1.1, U1.2 (-)
unnamed: R2B1.2, R3B1.2, U1.5 (+)
unnamed: R4B1.2, R5B1.2, U1.6 (-)
unnamed: R1C1.2, R2C1.1, U1.9 (-)
unnamed: R1D1.2, R5D1.1, U1.12 (+)
unnamed: R2D1.2, R3D1.2, U1.13 (-)
