FelipeAvilaSilva/Potentiostat_FullyDifferential/PCB/fully_differential/fully_differential/fully_differential_v4.kicad_pcb

## KiCad design PCB/fully_differential/fully_differential/fully_differential_v4.kicad_pcb (2023-08-18, an earlier design)

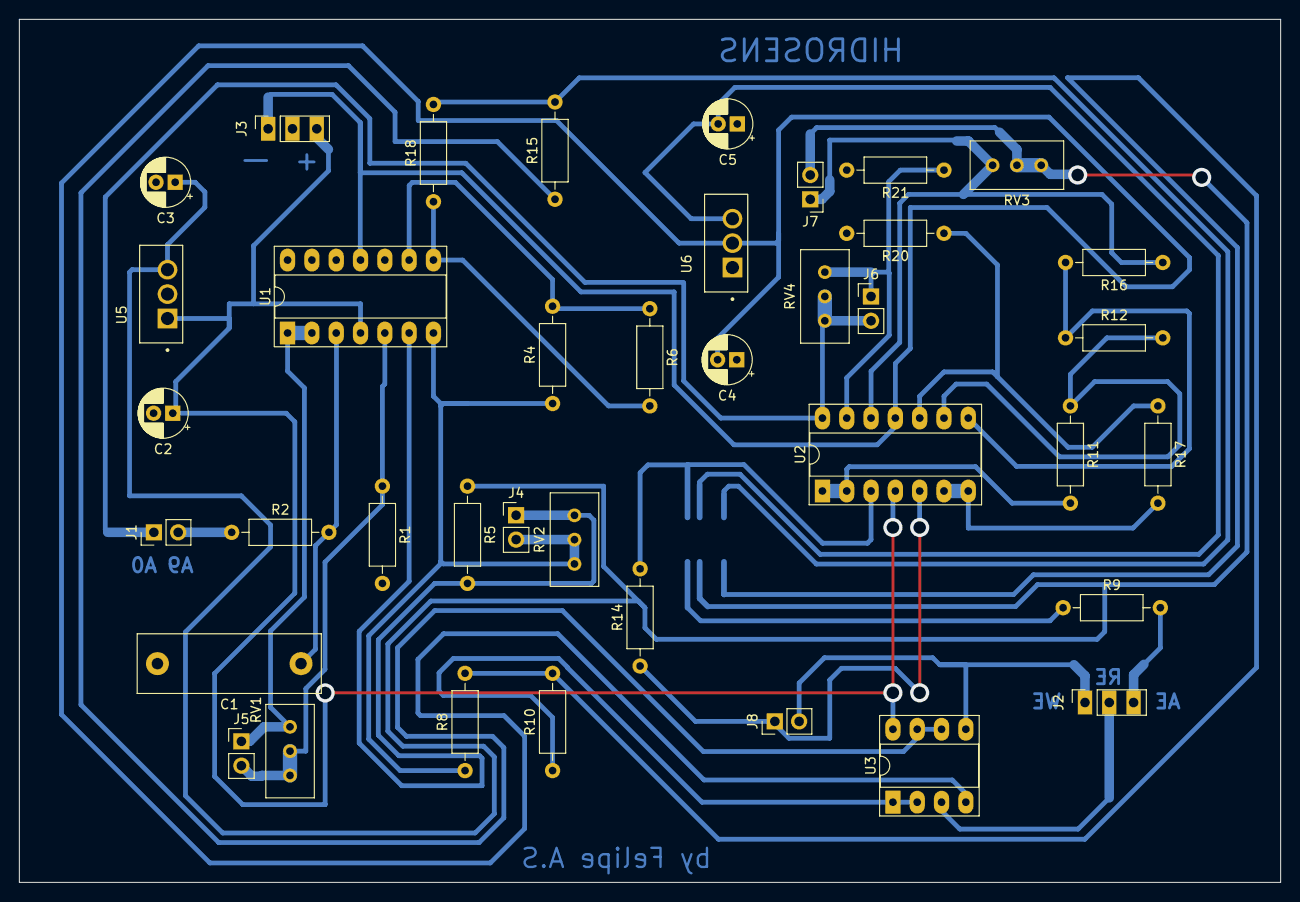
[picture p29: board fully_differential_v4.kicad_pcb from above]

Board: 2 copper layers, 131.8 x 90.2 mm, 40 parts (1 on the bottom side), 31 nets.

Parts:
C1: 470nF; C_Rect_L19.0mm_W6.0mm_P15.00mm_MKS4
C2, C3, C4, C5: 0.3uF; CP_Radial_D5.0mm_P2.00mm
J1, J4, J5, J6, J7, J8: Conn_01x02; PinHeader_1x02_P2.54mm_Vertical
J2, J3: Conn_01x03; PinSocket_1x03_P2.54mm_Vertical
R1, R4, R5, R6, R11, R12, R16, R17, R20, R21: 1K; R_Axial_DIN0207_L6.3mm_D2.5mm_P10.16mm_Horizontal
R2, R8, R10, R15, R18: 10K; R_Axial_DIN0207_L6.3mm_D2.5mm_P10.16mm_Horizontal
R9, R14: 2.2K; R_Axial_DIN0207_L6.3mm_D2.5mm_P10.16mm_Horizontal
RV1, RV2, RV3, RV4: R_Potentiometer_Trim; Potentiometer_Bourns_3296W_Vertical
U1, U2: LM324; DIP-14_W7.62mm_Socket_LongPads
U3: LM358; DIP-8_W7.62mm_Socket_LongPads
U4: AD8138ARZ; ANALOG_DEVICES_INC_AD8138ARZ_0
U5: L7805; TO255P1020X450X2000-3
U6: L7905; TO255P1020X450X2000-3

Connections:
+5V: C3.1, J7.2, R5.1, RV3.2, RV3.3, U4.3 (V+), U5.3 (OUT)
+9V: C2.1, J3.3, U1.4 (V+), U2.4, U3.8 (V+), U5.1 (IN)
-5V: C5.2, U4.6 (V-), U6.3 (VO)
-9V: C4.2, J3.1, U1.11 (V-), U2.11, U3.4 (V-), U6.2 (VI)
A0: J1.1, J6.2, RV4.2, RV4.3, U2.14
A9: J1.2, R2.1
GND: C1.2, C2.2, C3.2, C4.1, C5.1, J3.2, R1.2, R20.2, R21.2, U1.10 (+), U5.2 (GND), U6.1 (GND)
unnamed: J2.1, J8.2, U3.5 (+)
unnamed: J2.2, U3.3 (+)
unnamed: J2.3, R9.2
unnamed: J4.1, R5.2, RV2.1, U1.6 (-)
unnamed: J5.1, RV1.1, U1.1, U1.2 (-)
unnamed: J5.2, R1.1, RV1.2, RV1.3, U1.5 (+)
unnamed: J6.1, R21.1, RV4.1, U2.13 (-)
unnamed: J7.1, R16.1, RV3.1, U2.12 (+)
unnamed: J8.1, R14.1, U2.5 (+)
unnamed: R12.1, R16.2, U2.8
unnamed: C1.1, R2.2, U1.3 (+)
unnamed: R4.2, R6.1, U1.9 (-)
unnamed: R14.2, U2.3 (+), U4.5 (-OUT)
unnamed: R11.2, U2.1, U2.2 (-)
unnamed: R17.2, U2.6 (-), U2.7
unnamed: R17.1, R20.1, U2.10 (+)
unnamed: R11.1, R12.2, U2.9 (-)
unnamed: R10.1, U3.1, U3.2 (-)
unnamed: R15.1, U3.6 (-), U3.7
unnamed: R15.2, R18.2, U4.8 (+IN)
unnamed: R9.1, U4.4 (+OUT)
unnamed: R8.2, R10.2, U4.1 (-IN)
t+: J4.2, R4.1, R8.1, RV2.2, RV2.3, U1.7
t-: R6.2, R18.1, U1.8
