FelipeAvilaSilva/Potentiostat_FullyDifferential/PythonSerial/read_serial_v3.py

import serial.tools.list_ports
import time
import datetime
import numpy as np
import pandas as pd
import matplotlib.pyplot as plt
import plotly.express as px
import datetime as dt
from datetime import datetime
import re
from scipy.signal import savgol_filter


def writetxt():
    with open(nomeArquivo, "x+") as arquivo:
        while True:
            if serialInst.in_waiting:
                message = serialInst.readline().decode('utf').rstrip('\t\n')

                if FlagChars in message:
                    break  # Saia do loop quando encontrar FlagChars

                if beginMarker2 in message and endMarker2 in message:
                    padrao = r'\{(.*?)\}'
                    match = re.search(padrao, message)
                    if match:
                        strings = match.group(1).split(';')
                        strings = [s.strip() for s in strings if s.strip()]
                        tmp0, tmp1, tmp2 = strings  # Atribuição múltipla para descompactar os valores

                if beginMarker in message and endMarker in message:
                    for character in keyChars:
                        message = message.replace(character, "")
                    for character in FlagChars:
                        message = message.replace(character, "")
                    print(message)
                    arquivo.write(message.strip(" "))
                    serialInst.reset_input_buffer()


def writegraph(scanRate, startPotential, endPotential):
    df = pd.read_csv(nomeArquivo, delimiter=';', skipinitialspace=True)
    df['potencial'] = df.iloc[:, 0]
    df['potencial'] = df['potencial'][::-1].reset_index(drop=True)

    # Suavização da linha usando filtro de Savitzky-Golay
    window_size = 10  # Tamanho da janela, ajuste conforme necessário
    polynomial_order = 3  # Ordem do polinômio, ajuste conforme necessário
    df['potencial_smooth'] = savgol_filter(df['potencial'], window_size, polynomial_order)

    cores = ['blue' if df['potencial_smooth'][i] < df['potencial_smooth'][i+1] else 'red' for i in range(len(df)-1)]
    cores.insert(0, 'blue')

    fig, ax = plt.subplots()
    for i in range(10, len(df)-1):  # Começa do índice 10
        ax.plot([df['potencial_smooth'][i], df['potencial_smooth'][i+1]], [df.iloc[i, 1], df.iloc[i+1, 1]], color=cores[i], linewidth=1, solid_capstyle='round')

    ax.set_xlabel('Potencial (V)')
    ax.set_ylabel('Corrente (uA)')
    ax.set_title(f'Gráfico de Voltametria Cíclica\n\nScan Rate: {scanRate} mV/s | Start Potential: {startPotential} V | End Potential: {endPotential} V | Loop: {loop}', fontsize=10)
    plt.figtext(0.99, 0.01, f'Gerado em {dt.datetime.now().strftime("%d/%m/%Y %H:%M:%S")}', horizontalalignment='right')
    plt.show()

    

def writegraph2(scanRate, startPotential, endPotential):
    df = pd.read_csv(nomeArquivo, delimiter=';', skipinitialspace=True)
    df['potencial'] = df.iloc[:, 0]
    df['potencial'] = df['potencial'][::1].reset_index(drop=True)

    # Suavização da linha
    df_interpolated = df.interpolate()

    cores = ['blue' if df_interpolated['potencial'][i] < df_interpolated['potencial'][i+1] else 'red' for i in range(len(df_interpolated)-1)]
    cores.insert(0, 'blue')

    fig, ax = plt.subplots()
    for i in range(len(df_interpolated)-1):
        ax.plot([df_interpolated['potencial'][i], df_interpolated['potencial'][i+1]], [df_interpolated.iloc[i, 1], df_interpolated.iloc[i+1, 1]], color=cores[i], linewidth=1, solid_capstyle='round')

    ax.set_xlabel('Potencial (V)')
    ax.set_ylabel('Corrente (uA)')
    ax.set_title(f'Gráfico de Voltametria Cíclica\n\nScan Rate: {scanRate} mV/s | Start Potential: {startPotential} V | End Potential: {endPotential} V | Loop: {loop}', fontsize=10)
    plt.figtext(0.99, 0.01, f'Gerado em {dt.datetime.now().strftime("%d/%m/%Y %H:%M:%S")}', horizontalalignment='right')
    plt.show()
    



ports = serial.tools.list_ports.comports()
serialInst = serial.Serial()
portsList = []

beginMarker = '<'
endMarker = '>'

beginMarker2 = '{'
endMarker2 = '}'

keyChars = "<>"
FlagChars = '<finish>'
message = ''

temp = datetime.now().strftime("%Y%m%d-%H%M%S")
nomeArquivo = nomeArquivo = input("Digite o nome do arquivo a ser salvo (ex: meu_arquivo): ") + ".txt"

for onePort in ports:
    portsList.append(str(onePort))
    print(str(onePort))

#Descomentar a constante em outros PC's
#input("Digite o número da porta do seu Arduino")
    
val = 5
for x in range(0,len(portsList)):
    if portsList[x].startswith("COM" + str(val)):
        portVar = "COM" + str(val)
        print(portVar)

serialInst.baudrate = 115200
serialInst.port = portVar
serialInst.open()
time.sleep(1)


while True:
    print("\nSelecione uma técnica:")
    print("0 - Teste Automático")    
    print("1 - Voltametria Cíclica")
    print("2 - Voltametria de Varredura Linear")
    print("3 - Cronoamperometria")

    while True:
        try:
            selection = int(input("Digite sua escolha: "))
            if selection in [0, 1, 2, 3]:
                break
            else:
                print("Opção inválida! Tente novamente.")
        except ValueError:
            print("Entrada inválida! Tente novamente.")

    serialInst.write(str(selection).encode())

    if selection == 0:
        print("Aguarde...")
        scanRate = 100
        serialInst.write(str(scanRate).encode())
        time.sleep(2.5)
        startPotential = -1.5
        serialInst.write(str(startPotential).encode())
        time.sleep(2.5)
        endPotential = 1.5
        serialInst.write(str(endPotential).encode())
        time.sleep(2.5)
        loop = 1
        serialInst.write(str(loop).encode())
        time.sleep(2)
        print("Iniciando...")
        writetxt()
        writegraph(scanRate, startPotential, endPotential)
        

    if selection == 1:
        selection = input("\nInclua o SCAN RATE \nFaixa Permitida: 1 até 200 mV/s\n")
        serialInst.write(str(selection).encode())
        print("Scan rate = " + selection + " mV/s")
        scanRate = selection
        time.sleep(2.5)

        selection = input("\nInclua o Start potential \nFaixa Permitida: -Vmin até +Vmax volts\n")
        serialInst.write(str(selection).encode())
        print("Start Potential = " + str(selection) + " V")
        startPotential = selection
        time.sleep(2.5)

        selection = input("\nInclua o End potential \nFaixa Permitida: -Vmin até +Vmax volts\n")
        serialInst.write(str(selection).encode())
        print("End Potential = " + selection + " V")
        endPotential = selection
        time.sleep(2.5)

        selection = input("\nInclua o Loop \nFaixa Permitida: Loop >= 1 \n")
        serialInst.write(str(selection).encode())
        print("Loop = " + selection + "x\n")
        loop = selection
        time.sleep(2)

        print("Aguarde...")
        writetxt()
        writegraph(scanRate, startPotential, endPotential)

    if selection == 2:
        selection = input("\nInclua o SCAN RATE \nFaixa Permitida: 1 até 250 mV/s\n")
        serialInst.write(str(selection).encode())
        print("Scan rate = " + selection + " mV/s")
        scanRate = selection
        time.sleep(2.5)

        selection = input("\nInclua o Start potential \nFaixa Permitida: -Vmin até +Vmax volts\n")
        print("Perigo: Start < End potential")
        serialInst.write(str(selection).encode())
        print("Start Potential = " + str(selection) + " V")
        startPotential = selection
        time.sleep(2.5)

        selection = input("\nInclua o End potential \nFaixa Permitida: -Vmin até +Vmax volts\n")
        serialInst.write(str(selection).encode())
        print("End Potential = " + selection + " V")
        endPotential = selection
        time.sleep(2.5)

        selection = input("\nInclua o Loop \nFaixa Permitida: Loop >= 1 \n")
        serialInst.write(str(selection).encode())
        print("Loop = " + selection + "x\n")
        loop = selection
        time.sleep(2)

        print("Aguarde...")
        writetxt()
        writegraph2(scanRate, startPotential, endPotential)

    if selection == 3:
        selection = input("\nInclua o Start potential \nFaixa Permitida: -Vmin até +Vmax volts\n")
        serialInst.write(str(selection).encode())
        print("Start Potential = " + str(selection) + " V")
        startPotential = selection
        time.sleep(2.5)

        selection = input("\nInclua o tempo total de leitura (Em Seg)\n")
        serialInst.write(str(selection).encode())
        print("Tempo = " + str(selection) + " S")
        Delay = selection
        time.sleep(2.5)

        loop = 0

        print("Aguarde...")
        writetxt()      
        writegraph(0, startPotential, 0)

        
