FelipeAvilaSilva/Potentiostat_FullyDifferential/(commit log)

2022-11-22 init
    ISIS PROFESSIONAL
    [potenciostato_fully.DSN]
2022-11-22 fix
    falta vcell
    [potenciostato_fully.DSN]
2022-11-22 day ok
    [potenciostato_fully.DSN]
2023-02-09 add mod in 3 poten
    [poten_fully.DSN, poten_single.DSN, poten_stock.DSN, potenciostato_fully_v2.DSN, potenciostato_single_v1.DSN]
2023-02-13 att ampop corrente/tensão
    [poten_single.DSN]
2023-02-24 read arduino serial port with python
2023-02-28 add graph
    clear folder
    add txt
    fix signal single&fully
    [poten_fully.DSN, poten_single.DSN, poten_stock.DSN, potenciostato_fully.DSN, potenciostato_fully_v2.DSN, potenciostato_single_v1.DSN]
2023-03-14 add scan, start, end
    in python
    calibration
2023-03-29 test fully, add img, fix ino
    [Arduino_fully.ino, poten_single&fully.ino, poten_stock.ino, read_serial.py]
2023-04-24 fix fully
    fix ler dados, calibração, pwm, buffer, ad8138
    [poten_fully.DSN, poten_stock.DSN]
2023-04-25 fix pcb paste
    [poten_fully.DSN, stock.kicad_pcb, stock.kicad_sch]
2023-05-05 v1 pcb
    add basic, vcc-gnd
    [fully_differential.kicad_pcb, fully_differential.kicad_sch, poten_fully.DSN]
2023-05-22 new pcb
    falta validar para impressao
    [fully_differential.kicad_pcb, fully_differential.kicad_sch]
2023-05-26 pcb finalizado
    falta retirar divisor de tensao e mudar a leitura da tensao no resistor superior
    [fully_differential.kicad_pcb, fully_differential.kicad_sch, poten_stock.DSN]
2023-06-19 add v4
    versao da segunda impressão na cnc
    [fully_differential_v2.kicad_pcb, fully_differential_v2.kicad_sch, fully_differential_v3.kicad_pcb, fully_differential_v3.kicad_sch, fully_differential_v4.kicad_pcb, fully_differential_v4.kicad_sch, poten_fully_v2.DSN, poten_stock.DSN]
2023-07-04 fix proteus 1.5v and 3v
    stock v2 proteus and kicad ok
    fully v4 proteus and kicad ok
    [fully_differential.kicad_sch, fully_differential_v4.kicad_pcb, fully_differential_v4.kicad_sch, fully_differential_v5.kicad_pcb, fully_differential_v5.kicad_sch, poten_fully_v2.DSN, poten_stock.DSN, stock_v2.kicad_pcb]
2023-08-18 tudo ok
    se e fd pcb ok
    [TCC_FULLY.kicad_pcb, TCC_FULLY.kicad_sch, freerouting.dsn, fully_differential_v4.kicad_pcb, fully_differential_v8.kicad_pcb, fully_differential_v8.kicad_sch, fully_differential_vFINAL_BORA.kicad_sch, poten_fully_v2.DSN]
2023-08-23 Git for test lab
    Andar 1
    [poten_fully_vTCC.DSN, poten_single.DSN, poten_stock.DSN]
2023-10-25 Clean Code
    Clean Code in funtion voltametry cyclic
    SerialPython3 fix, delay, name.txt
    [Arduino_fully.ino, read_serial_v2.py, read_serial_v3.py]
2023-11-10 att
    melhorei definição de sobreamostragem, intervals delay, analogreference, velocidade serial
2023-11-10 fix scan rate
    att
    [Arduino_fully.ino, read_serial_v3.py]
2023-11-29 Att
    Troquei resistor r3 de 10k por 1k, adicionei filtro no python, eliminei os 10 primeiros pontos do grafico
    [TCC_FULLY.kicad_pcb]
2023-11-29 att
    agora funciona varredura de -1v a 1v no proteus
    [TCC_FULLY.kicad_sch, poten_fully_vTCC.DSN]
2023-12-05 Update
    Ultimo teste 2023
    [poten_fully_vTCC.DSN]
2023-12-06 Att
    add funcao 0 para teste, correção sentido do grafico de preview
2023-12-06 fix
    correção do zero bugado entre as medidas
    [Arduino_fully.ino]
2024-01-31 Version SMD
    Init pcb, lib
    [TCC_FULLY_SMD.kicad_pcb, TCC_FULLY_SMD.kicad_sch]
2024-01-31 schamatic
    init
    [TCC_FULLY_SMD.kicad_pcb]
